mte-capstone-ecards/Ecardz-EE/Ecardz-Proto-Rev2/Ecardz-Proto.step

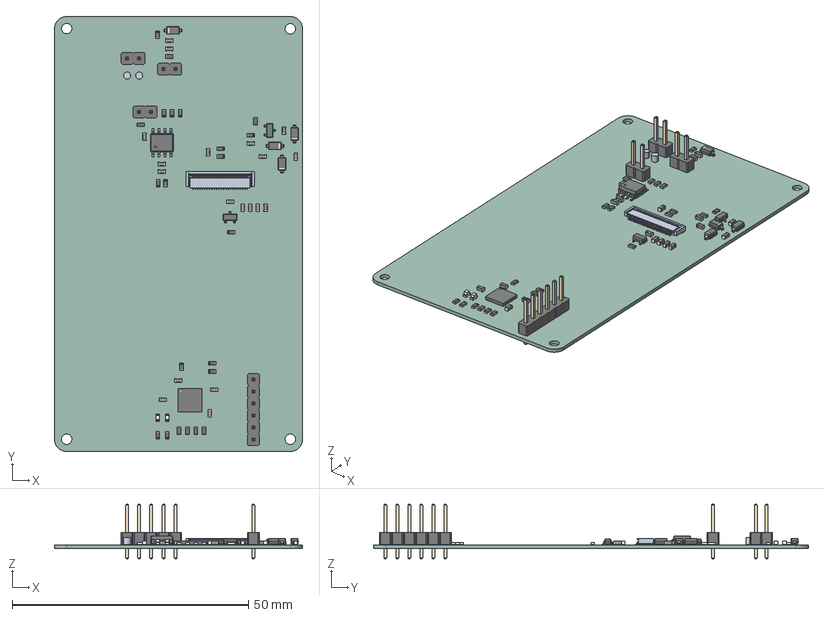
[picture p1: CAD file, 2025-03-11]
Ecardz-Proto-Rev2/Ecardz-Proto.step
52.5 x 92.0 x 11.5 mm
R_0603_1608Metric x 22
D_SOD_123 x 4
PinHeader_1x02_P254mm_Vertical x 3
C_0603_1608Metric x 19
SOT_23 x 2
LED_0603_1608Metric x 2
QFN-32-1EP_5x5mm_Pitch0.5mm
CQ assembly
Same_Sky_CPG-05-N-B x 2
PinHeader_1x06_P254mm_Vertical
P10051922_2410ELF
Ecardz-Proto_PCB
