mte-capstone-ecards/Ecardz-EE/highres_electronic_cards.dxf

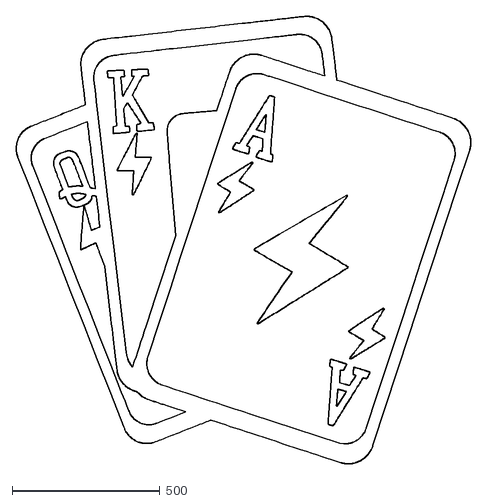
[picture p2: CAD file, 2025-02-24]
highres_electronic_cards.dxf
1536.4 x 1512.4
