mte-capstone-ecards/Ecardz-EE/Ecardz-Proto-Rev2/Same_Sky_CPG-05-N-B.step

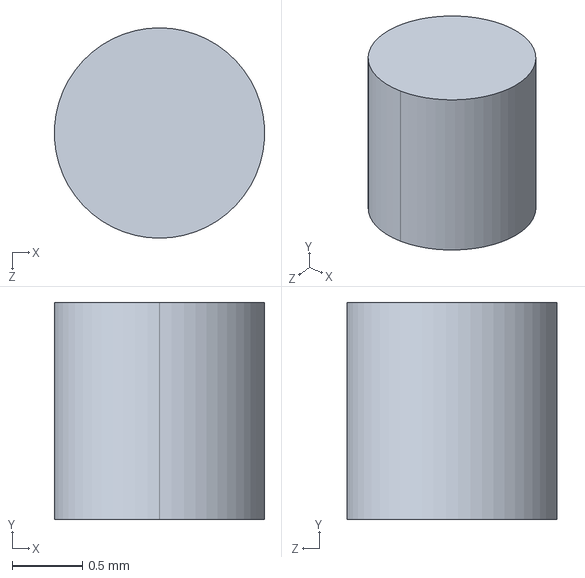
[picture p3: CAD file, 2025-02-23]
Ecardz-Proto-Rev2/Same_Sky_CPG-05-N-B.step
1.50 x 1.55 x 1.50 mm
