mte-capstone-ecards/Ecardz-EE/Ecardz-Proto-Rev2/s10051922_2410elf.stp

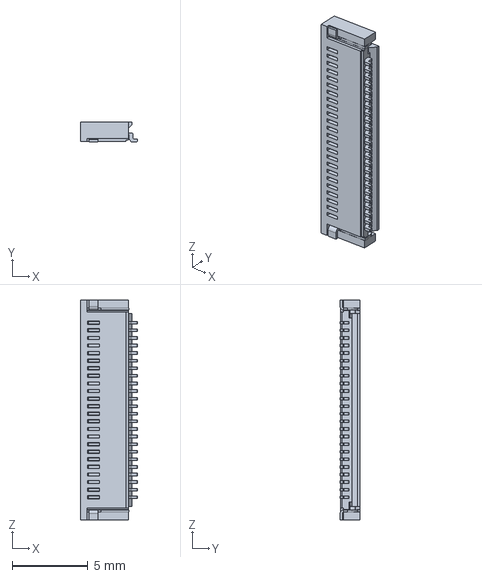
[picture p4: CAD file, 2025-02-23]
Ecardz-Proto-Rev2/s10051922_2410elf.stp
3.75 x 1.30 x 14.5 mm
