mte-capstone-ecards/Ecardz-EE/Ecardz-Proto-Rev2/Ecardz-Proto.kicad_pcb

## KiCad design Ecardz-Proto-Rev2/Ecardz-Proto.kicad_pcb (2025-03-11)

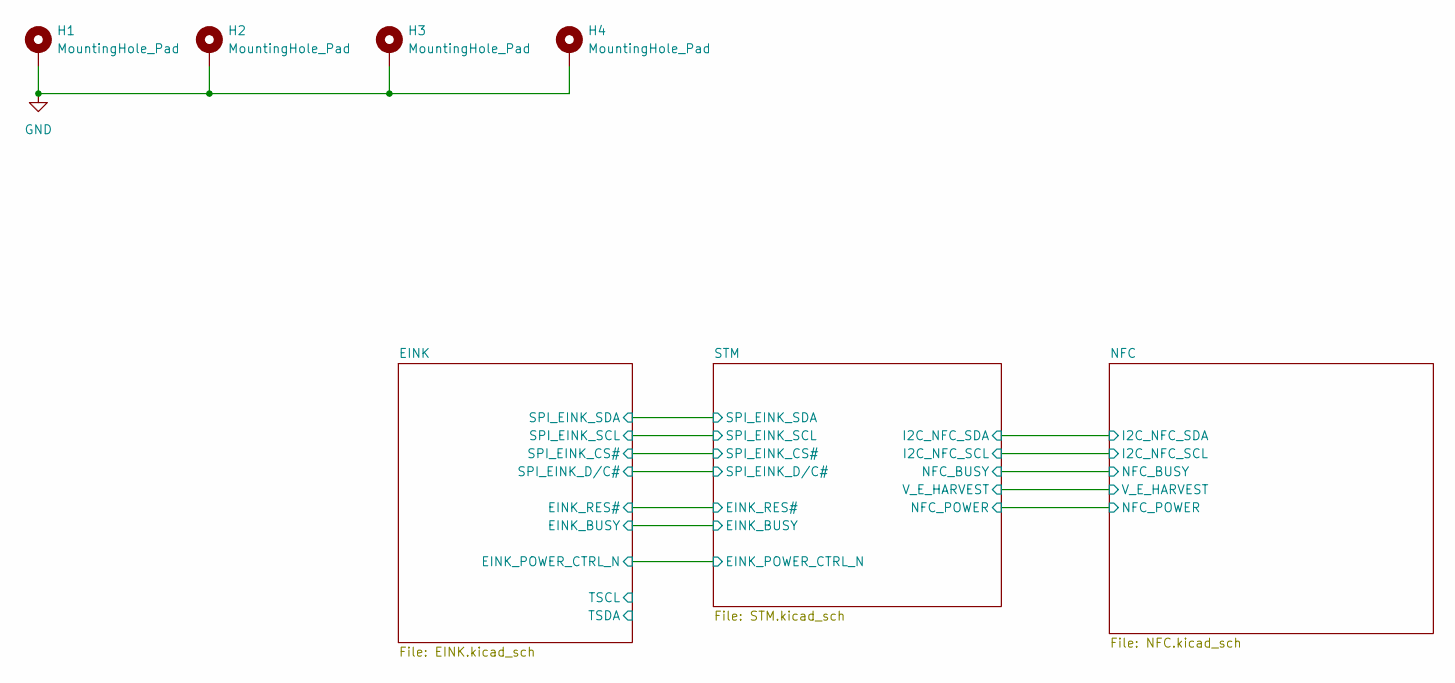
[picture p5: schematic Ecardz-Proto.kicad_sch]

Parts:
H1, H2, H3, H4: MountingHole_Pad; MountingHole_2.2mm_M2_DIN965

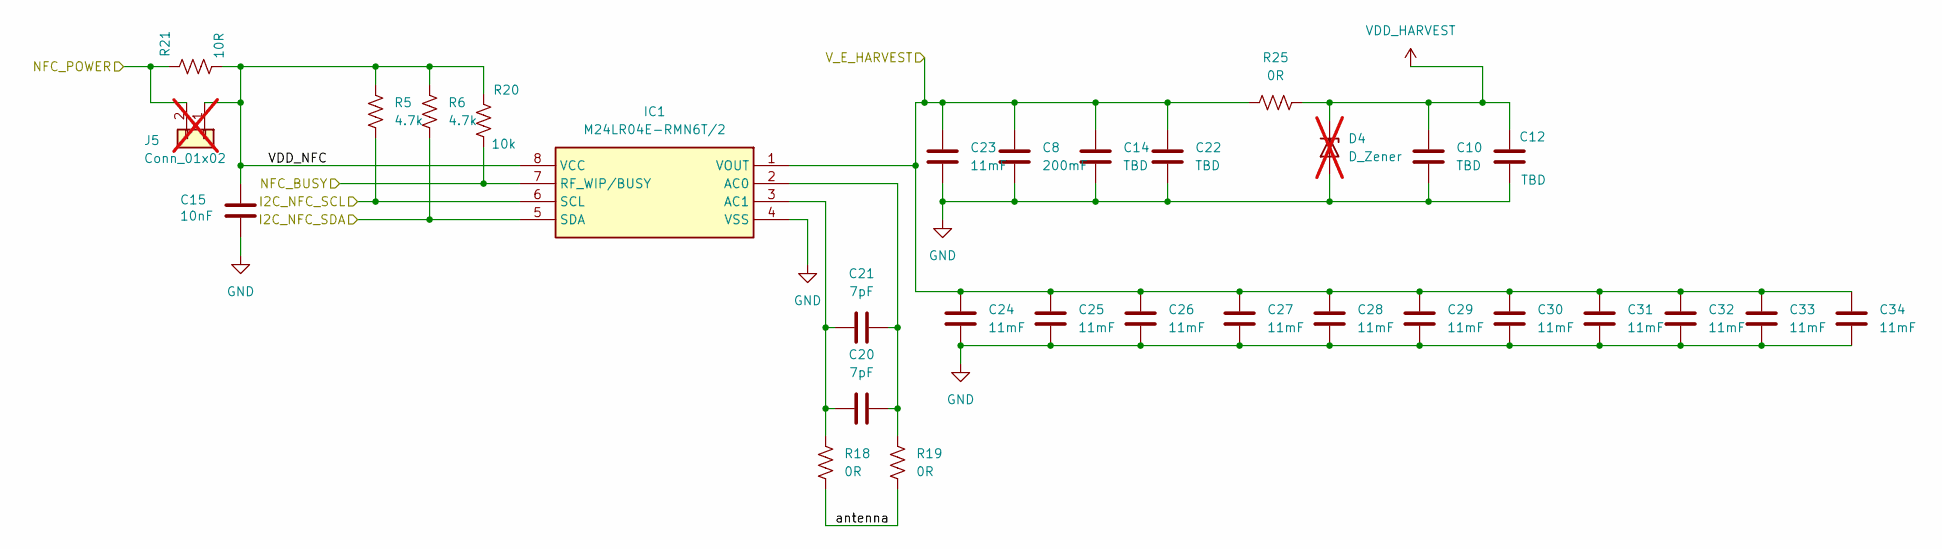
[picture p6: schematic NFC.kicad_sch]

Parts:
C8: 200mF; RSCSK2043R3D01004T; Digikey Part Number SCSK2043R3D01004T
C10, C12: TBD; C_0603_1608Metric_Pad1.08x0.95mm_HandSolder
C14, C22: TBD; C_2917
C15: 10nF; C_0603_1608Metric_Pad1.08x0.95mm_HandSolder; MANUFACTURER PART NUMBER C0603C102K5RACTU; Digikey Part Number 399-C0603C102K5RACTUTR-ND
C20, C21: 7pF; C_0603_1608Metric_Pad1.08x0.95mm_HandSolder; MANUFACTURER PART NUMBER GRM0335C1E7R0CA01D; Digikey Part Number 490-13324-2-ND
C23, C24, C25, C26, C27, C28, C29, C30, C31, C32, C33, C34: 11mF; CPH3225A; Digikey Part Number CPH3225A
D4: D_Zener; D_SOD-123; MANUFACTURER PART NUMBER MMSZ4684T1G; Digikey Part Number MMSZ4684T1GOSTR-ND; not fitted
IC1: M24LR04E-RMN6T/2; SO-8_3.9x4.9mm_P1.27mm; Mouser Part Number 511-M24LR04E-RDW6T/2
J5: Conn_01x02; PinHeader_1x02_P2.54mm_Vertical; not fitted
R5, R6: 4.7k; R_0603_1608Metric_Pad0.98x0.95mm_HandSolder; Part Number ERJ-3EKF4701V
R18, R19, R25: 0R; R_0603_1608Metric_Pad0.98x0.95mm_HandSolder; MANUFACTURER PART NUMBER CRCW0603590RFKEA; Digikey Part Number 541-590HTR-ND
R20: 10k; R_0603_1608Metric_Pad0.98x0.95mm_HandSolder; MANUFACTURER PART NUMBER RC0603FR-0710KL; Digikey Part Number 311-10.0KHRTR-ND
R21: 10R; R_0603_1608Metric_Pad0.98x0.95mm_HandSolder; MANUFACTURER PART NUMBER NRC06J100TRF

Connections:
/NFC/NFC_POWER: J5.2, R21.1; also elsewhere on the board
/NFC/VDD_NFC: C15.1, IC1.8 (VCC), J5.1, R5.1, R6.1, R20.1, R21.2
/NFC/V_E_HARVEST: C8.1, C14.1, C22.1, C23.1, C24.1, C25.1, C26.1, C27.1, C28.1, C29.1, C30.1, C31.1, C32.1, C33.1, C34.1, IC1.1 (VOUT), R25.1; also elsewhere on the board
/NFC/antenna: R18.1, R19.1
/STM/I2C_NFC_SCL: IC1.6 (SCL), R5.2; also elsewhere on the board
/STM/I2C_NFC_SDA: IC1.5 (SDA), R6.2; also elsewhere on the board
/STM/NFC_BUSY: IC1.7 (RF_WIP/BUSY), R20.2; also elsewhere on the board
GND: C8.2, C10.2, C12.2, C14.2, C15.2, C22.2, C23.2, C24.2, C25.2, C26.2, C27.2, C28.2, C29.2, C30.2, C31.2, C32.2, C33.2, C34.2, D4.2 (A), IC1.4 (VSS); also elsewhere on the board
unnamed: C20.2, C21.2, IC1.2 (AC0), R19.2
unnamed: C20.1, C21.1, IC1.3 (AC1), R18.2
VDD_HARVEST: C10.1, C12.1, D4.1 (K), R25.2; also elsewhere on the board

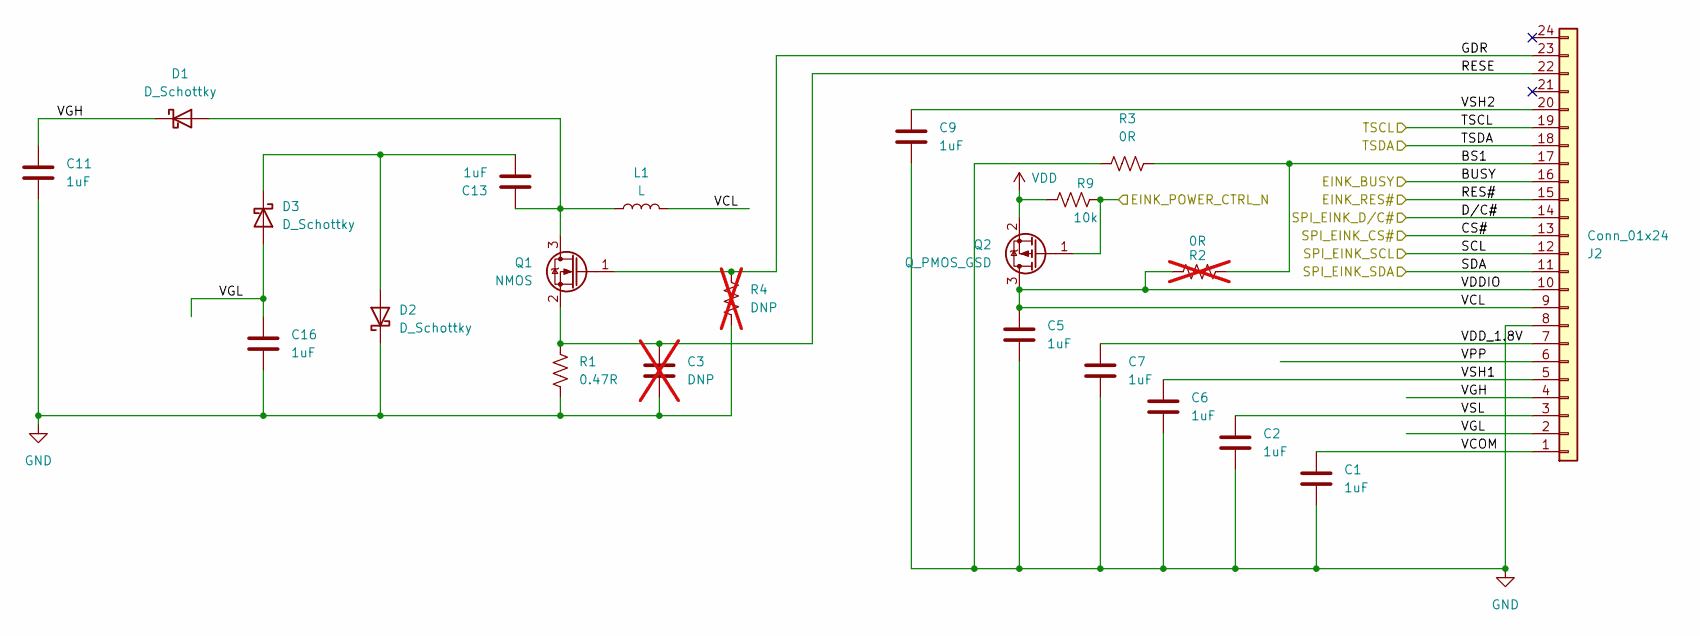
[picture p7: schematic EINK.kicad_sch]

Parts:
C1, C2, C5, C6, C7, C9, C11, C13, C16: 1uF; C_0603_1608Metric_Pad1.08x0.95mm_HandSolder; MANUFACTURER PART NUMBER CC0603KRX5R8BB105; Digikey Part Number 311-1445-2-ND
C3: DNP; C_0603_1608Metric_Pad1.08x0.95mm_HandSolder; MANUFACTURER PART NUMBER 100pF; not fitted
D1, D2, D3: D_Schottky; D_SOD-123; MANUFACTURER PART NUMBER MBR0530T1G; Digikey Part Number MBR0530T1GOSTR-ND
J2: Conn_01x24; TE_2-1734839-4_1x24-1MP_P0.5mm_Horizontal; MANUFACTURER PART NUMBER 4-1734839-5; Digikey Part Number A101358TR-ND
L1: L; CDRH5D18; MANUFACTURER PART NUMBER CDRH5D18NP-470NC; Digikey Part Number 308-2060-2-ND
Q1: NMOS; SOT-23; MANUFACTURER PART NUMBER IRLML2803TRPBF; Digikey Part Number IRLML2803PBFTR-ND
Q2: Q_PMOS_GSD; SOT-23; MANUFACTURER PART NUMBER BSS138NH6433XTMA1
R1: 0.47R; R_0603_1608Metric_Pad0.98x0.95mm_HandSolder; MANUFACTURER PART NUMBER ERJ-3RQJR47V; Digikey Part Number ERJ-3RQJR47V
R2: 0R; R_0603_1608Metric_Pad0.98x0.95mm_HandSolder; MANUFACTURER PART NUMBER RC0603JR-070RL; Digikey Part Number 311-0.0GRTR-ND; not fitted
R3: 0R; R_0603_1608Metric_Pad0.98x0.95mm_HandSolder; MANUFACTURER PART NUMBER RC0603JR-070RL; Digikey Part Number 311-0.0GRTR-ND
R4: DNP; R_0603_1608Metric_Pad0.98x0.95mm_HandSolder; MANUFACTURER PART NUMBER 100kR; not fitted
R9: 10k; R_0603_1608Metric_Pad0.98x0.95mm_HandSolder; MANUFACTURER PART NUMBER RC0603FR-0710KL; Digikey Part Number 311-10.0KHRTR-ND

Connections:
/EINK/BS1: J2.17, R2.2, R3.2
/EINK/BUSY: J2.16; also elsewhere on the board
/EINK/CS#: J2.13; also elsewhere on the board
/EINK/D/C#: J2.14; also elsewhere on the board
/EINK/EINK_POWER_CTRL_N: Q2.1 (G), R9.2; also elsewhere on the board
/EINK/GDR: J2.23, Q1.1 (G), R4.1
/EINK/RES#: J2.15; also elsewhere on the board
/EINK/RESE: C3.1, J2.22, Q1.2 (S), R1.1
/EINK/SCL: J2.12; also elsewhere on the board
/EINK/SDA: J2.11; also elsewhere on the board
/EINK/TSCL: J2.19
/EINK/TSDA: J2.18
/EINK/VCL: C5.1, J2.9, J2.10, L1.2, Q2.3 (D), R2.1
/EINK/VCOM: C1.1, J2.1
/EINK/VDD_1.8V: C7.1, J2.7
/EINK/VGH: C11.1, D1.1 (K), J2.4
/EINK/VGL: C16.1, D3.2 (A), J2.2
/EINK/VPP: J2.6
/EINK/VSH1: C6.1, J2.5
/EINK/VSH2: C9.1, J2.20
/EINK/VSL: C2.1, J2.3
GND: C1.2, C2.2, C3.2, C5.2, C6.2, C7.2, C9.2, C11.2, C16.2, D2.1 (K), J2.8, R1.2, R3.1, R4.2; also elsewhere on the board
unnamed: C13.1, D1.2 (A), L1.1, Q1.3 (D)
unnamed: C13.2, D2.2 (A), D3.1 (K)
VDD: Q2.2 (S), R9.1; also elsewhere on the board

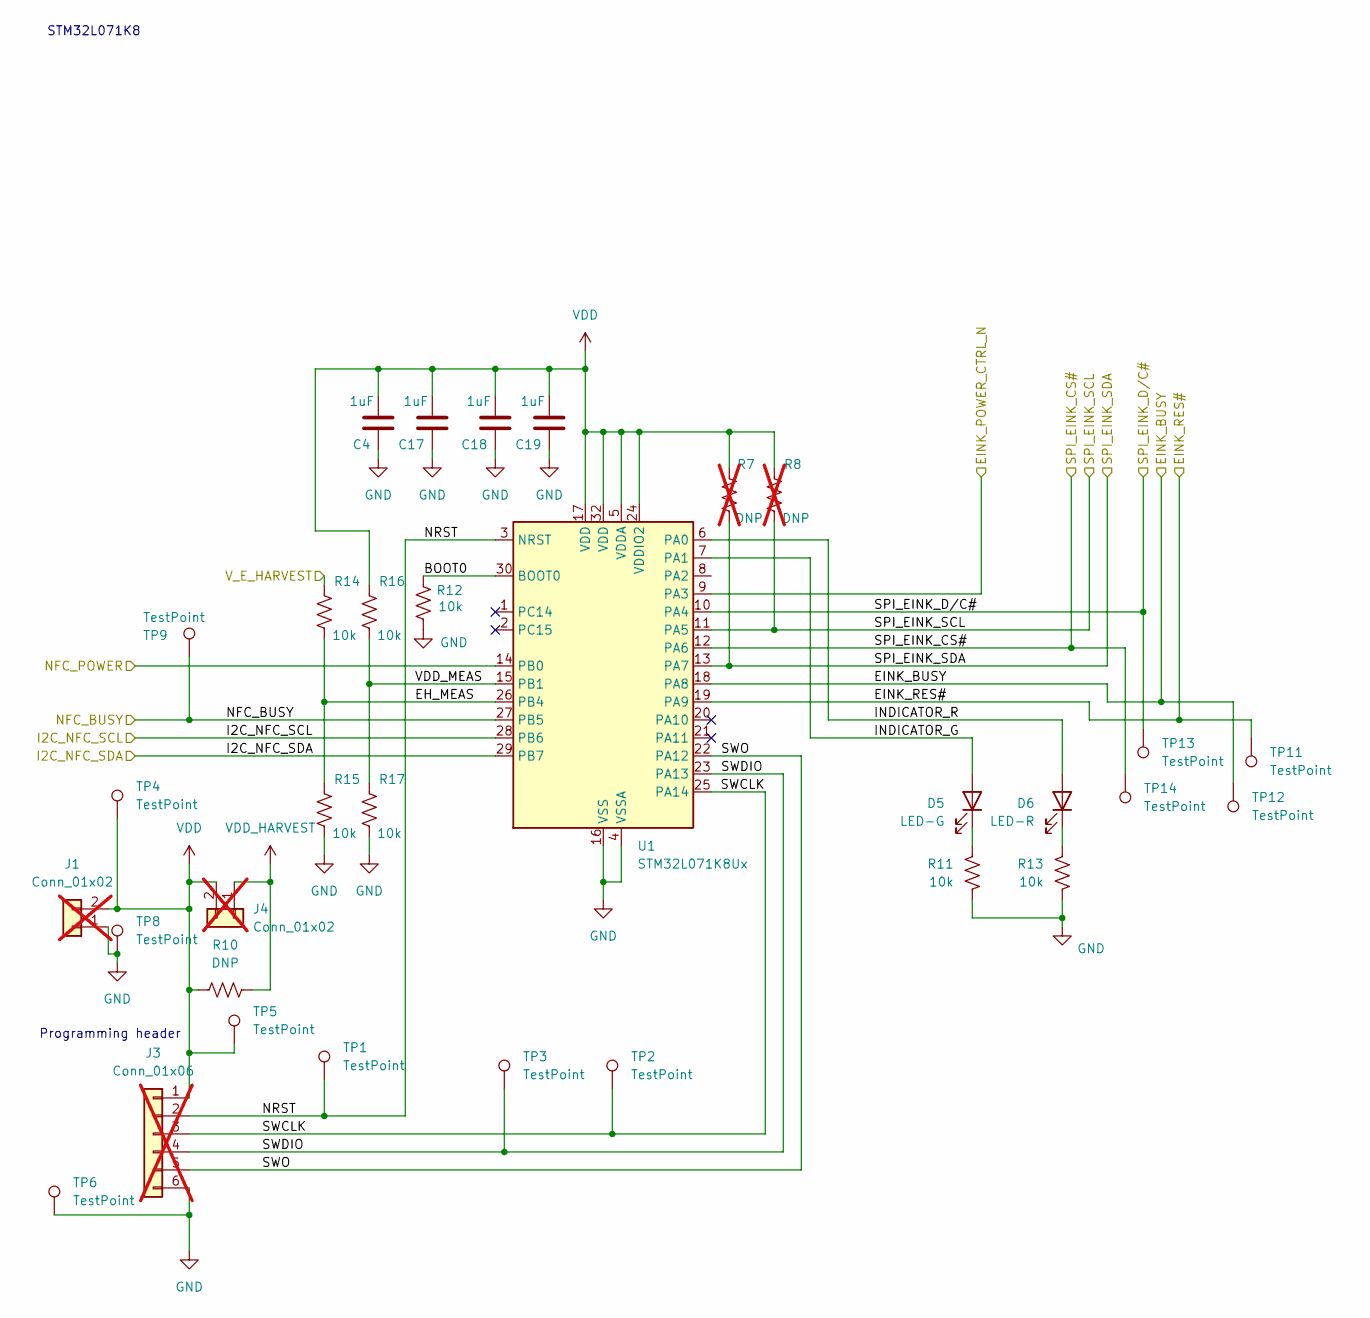
[picture p8: schematic STM.kicad_sch]

Parts:
C4, C17, C18, C19: 1uF; C_0603_1608Metric_Pad1.08x0.95mm_HandSolder; MANUFACTURER PART NUMBER CC0603KRX5R8BB105; Digikey Part Number 311-1445-2-ND
D5: LED-G; LED_0603_1608Metric_Pad1.05x0.95mm_HandSolder; MANUFACTURER PART NUMBER 150060GS75000
D6: LED-R; LED_0603_1608Metric_Pad1.05x0.95mm_HandSolder; MANUFACTURER PART NUMBER 150060RS75000
J1, J4: Conn_01x02; PinHeader_1x02_P2.54mm_Vertical; not fitted
J3: Conn_01x06; PinHeader_1x06_P2.54mm_Vertical; not fitted
R7, R8: DNP; R_0603_1608Metric_Pad0.98x0.95mm_HandSolder; MANUFACTURER PART NUMBER 100kR; not fitted
R10: DNP; R_0603_1608Metric_Pad0.98x0.95mm_HandSolder; MANUFACTURER PART NUMBER RC0603JR-070RL
R11, R13: 10k; R_0603_1608Metric_Pad0.98x0.95mm_HandSolder; Part Number RC0603FR-0710KL
R12, R14, R15, R16, R17: 10k; R_0603_1608Metric_Pad0.98x0.95mm_HandSolder; MANUFACTURER PART NUMBER RC0603FR-0710KL; Digikey Part Number 311-10.0KHRTR-ND
TP1, TP2, TP3, TP5, TP6, TP9, TP11, TP12, TP13, TP14: TestPoint; TestPoint_Pad_2.0x2.0mm
TP4, TP8: TestPoint; TestPoint_Pad_D1.5mm
U1: STM32L071K8Ux; QFN-32-1EP_5x5mm_P0.5mm_EP3.45x3.45mm; MANUFACTURER PART NUMBER STM32L071K8U6; Digikey Part Number 497-18576-ND

Connections:
/EINK/BUSY: TP12.1, U1.18 (PA8); also elsewhere on the board
/EINK/CS#: TP14.1, U1.12 (PA6); also elsewhere on the board
/EINK/D/C#: TP13.1, U1.10 (PA4); also elsewhere on the board
/EINK/EINK_POWER_CTRL_N: U1.9 (PA3); also elsewhere on the board
/EINK/RES#: TP11.1, U1.19 (PA9); also elsewhere on the board
/EINK/SCL: R8.2, U1.11 (PA5); also elsewhere on the board
/EINK/SDA: R7.2, U1.13 (PA7); also elsewhere on the board
/NFC/NFC_POWER: U1.14 (PB0); also elsewhere on the board
/NFC/V_E_HARVEST: R14.1; also elsewhere on the board
/STM/BOOT0: R12.1, U1.30 (BOOT0)
/STM/EH_MEAS: R14.2, R15.1, U1.26 (PB4)
/STM/I2C_NFC_SCL: U1.28 (PB6); also elsewhere on the board
/STM/I2C_NFC_SDA: U1.29 (PB7); also elsewhere on the board
/STM/INDICATOR_G: D5.2 (A), U1.7 (PA1)
/STM/INDICATOR_R: D6.2 (A), U1.6 (PA0)
/STM/NFC_BUSY: TP9.1, U1.27 (PB5); also elsewhere on the board
/STM/NRST: J3.2, TP1.1, U1.3 (NRST)
/STM/SWCLK: J3.3, TP2.1, U1.25 (PA14)
/STM/SWDIO: J3.4, TP3.1, U1.23 (PA13)
/STM/SWO: J3.5, U1.22 (PA12)
/STM/VDD_MEAS: R16.2, R17.1, U1.15 (PB1)
GND: C4.1, C17.1, C18.1, C19.1, J1.1, J3.6, R11.2, R12.2, R13.2, R15.2, R17.2, TP6.1, TP8.1, U1.4 (VSSA), U1.16 (VSS), U1.31 (VSS), U1.33 (VSS); also elsewhere on the board
unnamed: D5.1 (K), R11.1
unnamed: D6.1 (K), R13.1
VDD: C4.2, C17.2, C18.2, C19.2, J1.2, J3.1, J4.2, R7.1, R8.1, R10.1, R16.1, TP4.1, TP5.1, U1.5 (VDDA), U1.17 (VDD), U1.24 (VDDIO2), U1.32 (VDD); also elsewhere on the board
VDD_HARVEST: J4.1, R10.2; also elsewhere on the board

Notes on the sheet:
STM32L071K8
Programming header

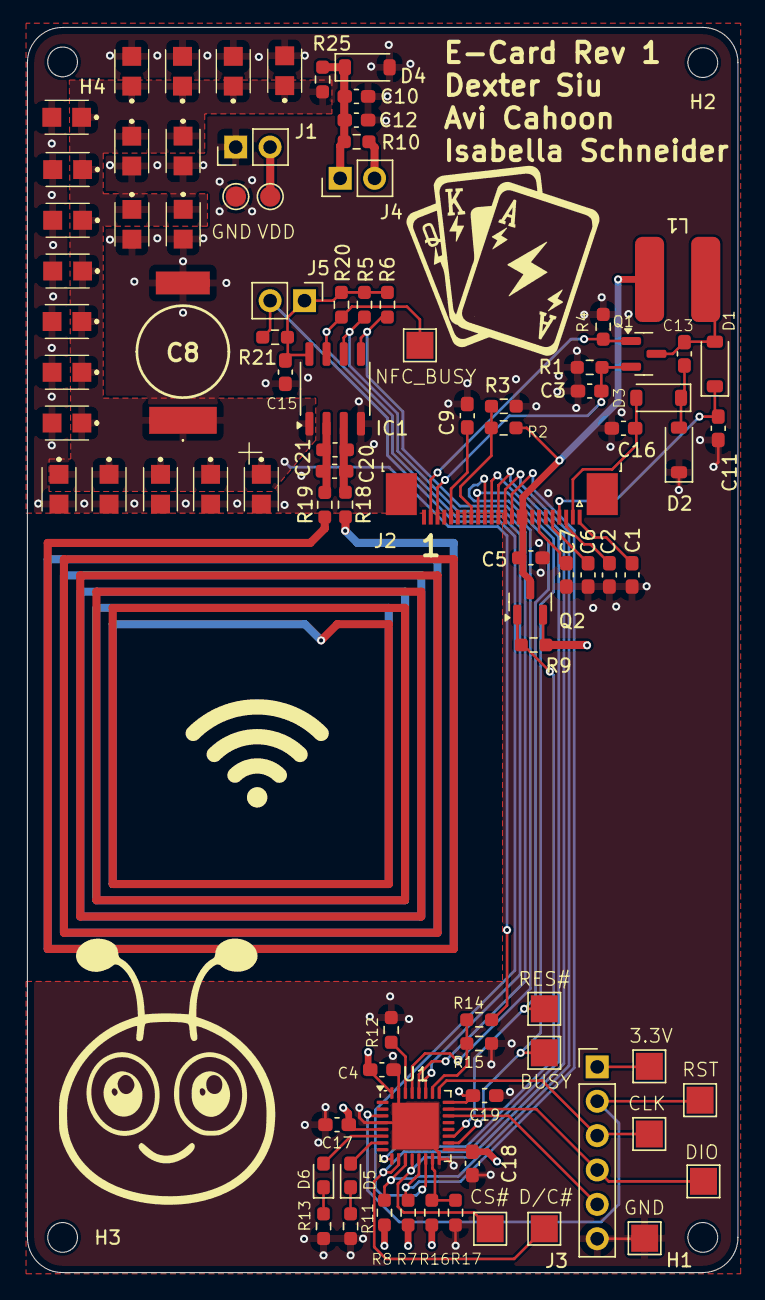
[picture p9: board Ecardz-Proto-Rev2/Ecardz-Proto.kicad_pcb from above]

Board: 4 copper layers, 52.5 x 92.0 mm, 94 parts (0 on the bottom side), 43 nets.

Other parts of the board:
C23#2, C23#3, C26#2, C26#3, C26#4, C30#2, C30#3, C30#4: 11mF; CPH3225A

Their connections:
/NFC/V_E_HARVEST: C23#2.1, C23#3.1, C26#2.1, C26#3.1, C26#4.1, C30#2.1, C30#3.1, C30#4.1; also elsewhere on the board
GND: C23#2.2, C23#3.2, C26#2.2, C26#3.2, C26#4.2, C30#2.2, C30#3.2, C30#4.2; also elsewhere on the board
