mte-capstone-ecards/Ecardz-EE/Ecardz-Controller/Ecardz-Controller.kicad_pcb

## KiCad design Ecardz-Controller/Ecardz-Controller.kicad_pcb (2025-01-20)

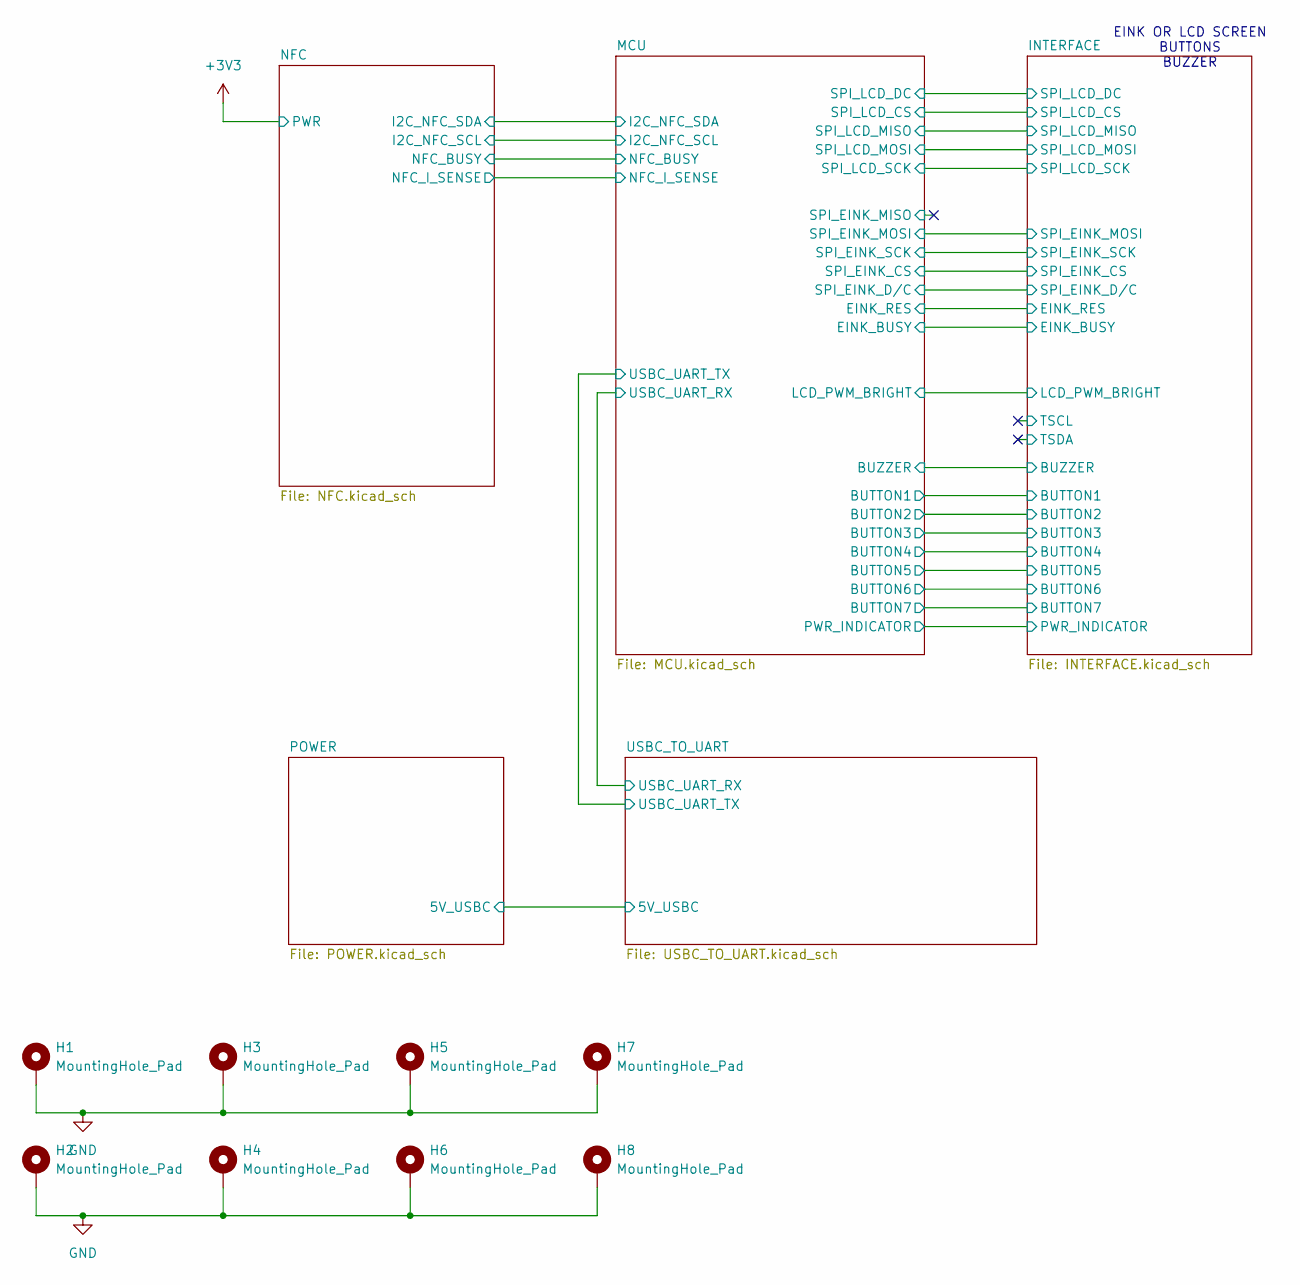
[picture p10: schematic Ecardz-Controller.kicad_sch]

Parts:
H1, H2, H3, H4, H5, H6, H7, H8: MountingHole_Pad; MountingHole_2.7mm_M2.5_Pad_TopBottom

Connections:
GND: H1.1, H2.1, H3.1, H4.1, H5.1, H6.1, H7.1, H8.1; also elsewhere on the board

Notes on the sheet:
EINK OR LCD SCREEN BUTTONS BUZZER

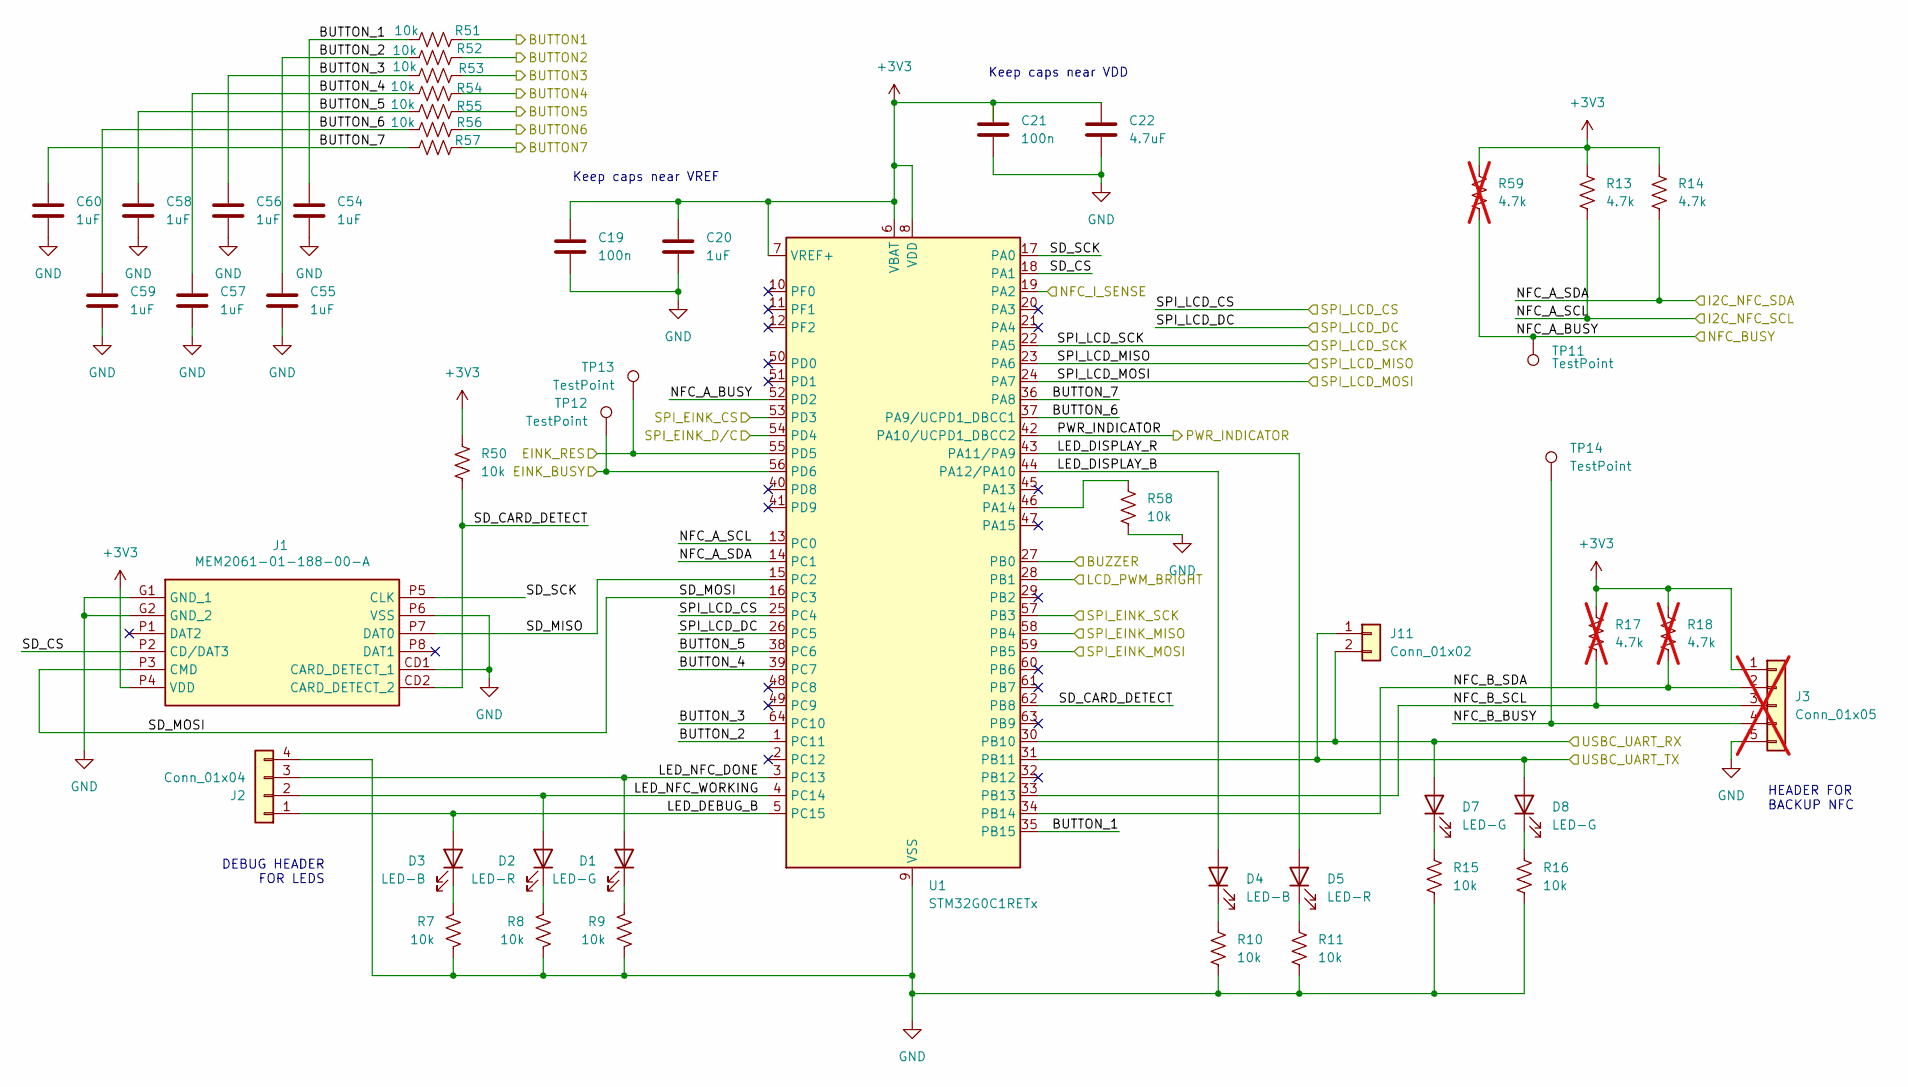
[picture p11: schematic MCU.kicad_sch]

Parts:
C19, C21: 100n; C_0603_1608Metric_Pad1.08x0.95mm_HandSolder; Part Number CC0603KRX7R7BB104
C20, C54, C55, C56, C57, C58, C59, C60: 1uF; C_0603_1608Metric_Pad1.08x0.95mm_HandSolder; Part Number CC0603KRX5R8BB105
C22: 4.7uF; C_0603_1608Metric_Pad1.08x0.95mm_HandSolder; Part Number CL10A475KP8NNNC
D1, D7, D8: LED-G; LED_0603_1608Metric_Pad1.05x0.95mm_HandSolder; Part Number 150060GS75000
D2, D5: LED-R; LED_0603_1608Metric_Pad1.05x0.95mm_HandSolder; Part Number 150060RS75000
D3, D4: LED-B; LED_0603_1608Metric_Pad1.05x0.95mm_HandSolder; Part Number 150060BS75000
J1: MEM2061-01-188-00-A; MEM20610118800A; Mouser Part Number 640-MEM20610118800A
J2: Conn_01x04; PinHeader_1x04_P2.54mm_Horizontal; Part Number 61300411121
J3: Conn_01x05; PinHeader_1x05_P2.54mm_Horizontal; Part Number 61300511121; not fitted
J11: Conn_01x02; PinHeader_1x02_P2.54mm_Horizontal
R7, R8, R9, R10, R11, R15, R16, R50, R51, R52, R53, R54, R55, R56, R57, R58: 10k; R_0603_1608Metric_Pad0.98x0.95mm_HandSolder; Part Number RC0603FR-0710KL
R13, R14: 4.7k; R_0603_1608Metric_Pad0.98x0.95mm_HandSolder; Part Number ERJ-3EKF4701V
R17, R18, R59: 4.7k; R_0603_1608Metric_Pad0.98x0.95mm_HandSolder; Part Number ERJ-3EKF4701V; not fitted
TP11, TP12, TP13, TP14: TestPoint; TestPoint_Pad_D3.0mm
U1: STM32G0C1RETx; LQFP-64_10x10mm_P0.5mm; Part Number STM32G0C1RETx

Connections:
+3V3: C19.1, C20.1, C21.1, C22.1, J1.P4 (VDD), J3.1, R13.1, R14.1, R17.1, R18.1, R50.1, R59.1, U1.6 (VBAT), U1.7 (VREF+), U1.8 (VDD); also elsewhere on the board
/INTERFACE/BUSY: TP12.1, U1.56 (PD6); also elsewhere on the board
/INTERFACE/BUTTON1: R51.2; also elsewhere on the board
/INTERFACE/BUTTON2: R52.2; also elsewhere on the board
/INTERFACE/BUTTON3: R53.2; also elsewhere on the board
/INTERFACE/BUTTON4: R54.2; also elsewhere on the board
/INTERFACE/BUTTON5: R55.2; also elsewhere on the board
/INTERFACE/BUTTON6: R56.2; also elsewhere on the board
/INTERFACE/BUTTON7: R57.2; also elsewhere on the board
/INTERFACE/BUZZER: U1.27 (PB0); also elsewhere on the board
/INTERFACE/CS#: U1.53 (PD3); also elsewhere on the board
/INTERFACE/D/C#: U1.54 (PD4); also elsewhere on the board
/INTERFACE/LCD_PWM_BRIGHT: U1.28 (PB1); also elsewhere on the board
/INTERFACE/RES#: TP13.1, U1.55 (PD5); also elsewhere on the board
/INTERFACE/SCL: U1.57 (PB3); also elsewhere on the board
/INTERFACE/SDA: U1.59 (PB5); also elsewhere on the board
/MCU/BUTTON_1: C54.1, R51.1, U1.35 (PB15)
/MCU/BUTTON_2: C55.1, R52.1, U1.1 (PC11)
/MCU/BUTTON_3: C56.1, R53.1, U1.64 (PC10)
/MCU/BUTTON_4: C57.1, R54.1, U1.39 (PC7)
/MCU/BUTTON_5: C58.1, R55.1, U1.38 (PC6)
/MCU/BUTTON_6: C59.1, R56.1, U1.37 (PA9/UCPD1_DBCC1)
/MCU/BUTTON_7: C60.1, R57.1, U1.36 (PA8)
/MCU/LED_DEBUG_B: D3.2 (A), J2.1, U1.5 (PC15)
/MCU/LED_DISPLAY_B: D4.2 (A), U1.44 (PA12/PA10)
/MCU/LED_DISPLAY_R: D5.2 (A), U1.43 (PA11/PA9)
/MCU/LED_NFC_DONE: D1.2 (A), J2.3, U1.3 (PC13)
/MCU/LED_NFC_WORKING: D2.2 (A), J2.2, U1.4 (PC14)
/MCU/NFC_A_BUSY: R59.2, TP11.1, U1.52 (PD2); also elsewhere on the board
/MCU/NFC_A_SCL: R13.2, U1.13 (PC0); also elsewhere on the board
/MCU/NFC_A_SDA: R14.2, U1.14 (PC1); also elsewhere on the board
/MCU/NFC_B_BUSY: J3.4, TP14.1
/MCU/NFC_B_SCL: J3.3, R17.2, U1.33 (PB13)
/MCU/NFC_B_SDA: J3.2, R18.2, U1.34 (PB14)
/MCU/NFC_I_SENSE: U1.19 (PA2); also elsewhere on the board
/MCU/PWR_INDICATOR: U1.42 (PA10/UCPD1_DBCC2); also elsewhere on the board
/MCU/SD_CARD_DETECT: J1.CD2 (CARD_DETECT_2), R50.2, U1.62 (PB8)
/MCU/SD_CS: J1.P2 (CD/DAT3), U1.18 (PA1)
/MCU/SD_MISO: J1.P7 (DAT0), U1.15 (PC2)
/MCU/SD_MOSI: J1.P3 (CMD), U1.16 (PC3)
/MCU/SD_SCK: J1.P5 (CLK), U1.17 (PA0)
/MCU/SPI_EINK_MISO: U1.58 (PB4)
/MCU/SPI_LCD_CS: U1.25 (PC4); also elsewhere on the board
/MCU/SPI_LCD_DC: U1.26 (PC5); also elsewhere on the board
/MCU/SPI_LCD_MISO: U1.23 (PA6); also elsewhere on the board
/MCU/SPI_LCD_MOSI: U1.24 (PA7); also elsewhere on the board
/MCU/SPI_LCD_SCK: U1.22 (PA5); also elsewhere on the board
/MCU/USBC_UART_RX: D7.2 (A), J11.2, U1.30 (PB10); also elsewhere on the board
/MCU/USBC_UART_TX: D8.2 (A), J11.1, U1.31 (PB11); also elsewhere on the board
GND: C19.2, C20.2, C21.2, C22.2, C54.2, C55.2, C56.2, C57.2, C58.2, C59.2, C60.2, J1.CD1 (CARD_DETECT_1), J1.G1 (GND_1), J1.G2 (GND_2), J1.P6 (VSS), J2.4, J3.5, R7.2, R8.2, R9.2, R10.2, R11.2, R15.2, R16.2, R58.2, U1.9 (VSS); also elsewhere on the board
unnamed: D1.1 (K), R9.1
unnamed: D2.1 (K), R8.1
unnamed: D3.1 (K), R7.1
unnamed: D4.1 (K), R10.1
unnamed: D5.1 (K), R11.1
unnamed: D7.1 (K), R15.1
unnamed: D8.1 (K), R16.1
unnamed: R58.1, U1.46 (PA14)

Notes on the sheet:
HEADER FOR BACKUP NFC
DEBUG HEADER FOR LEDS
Keep caps near VDD
Keep caps near VREF

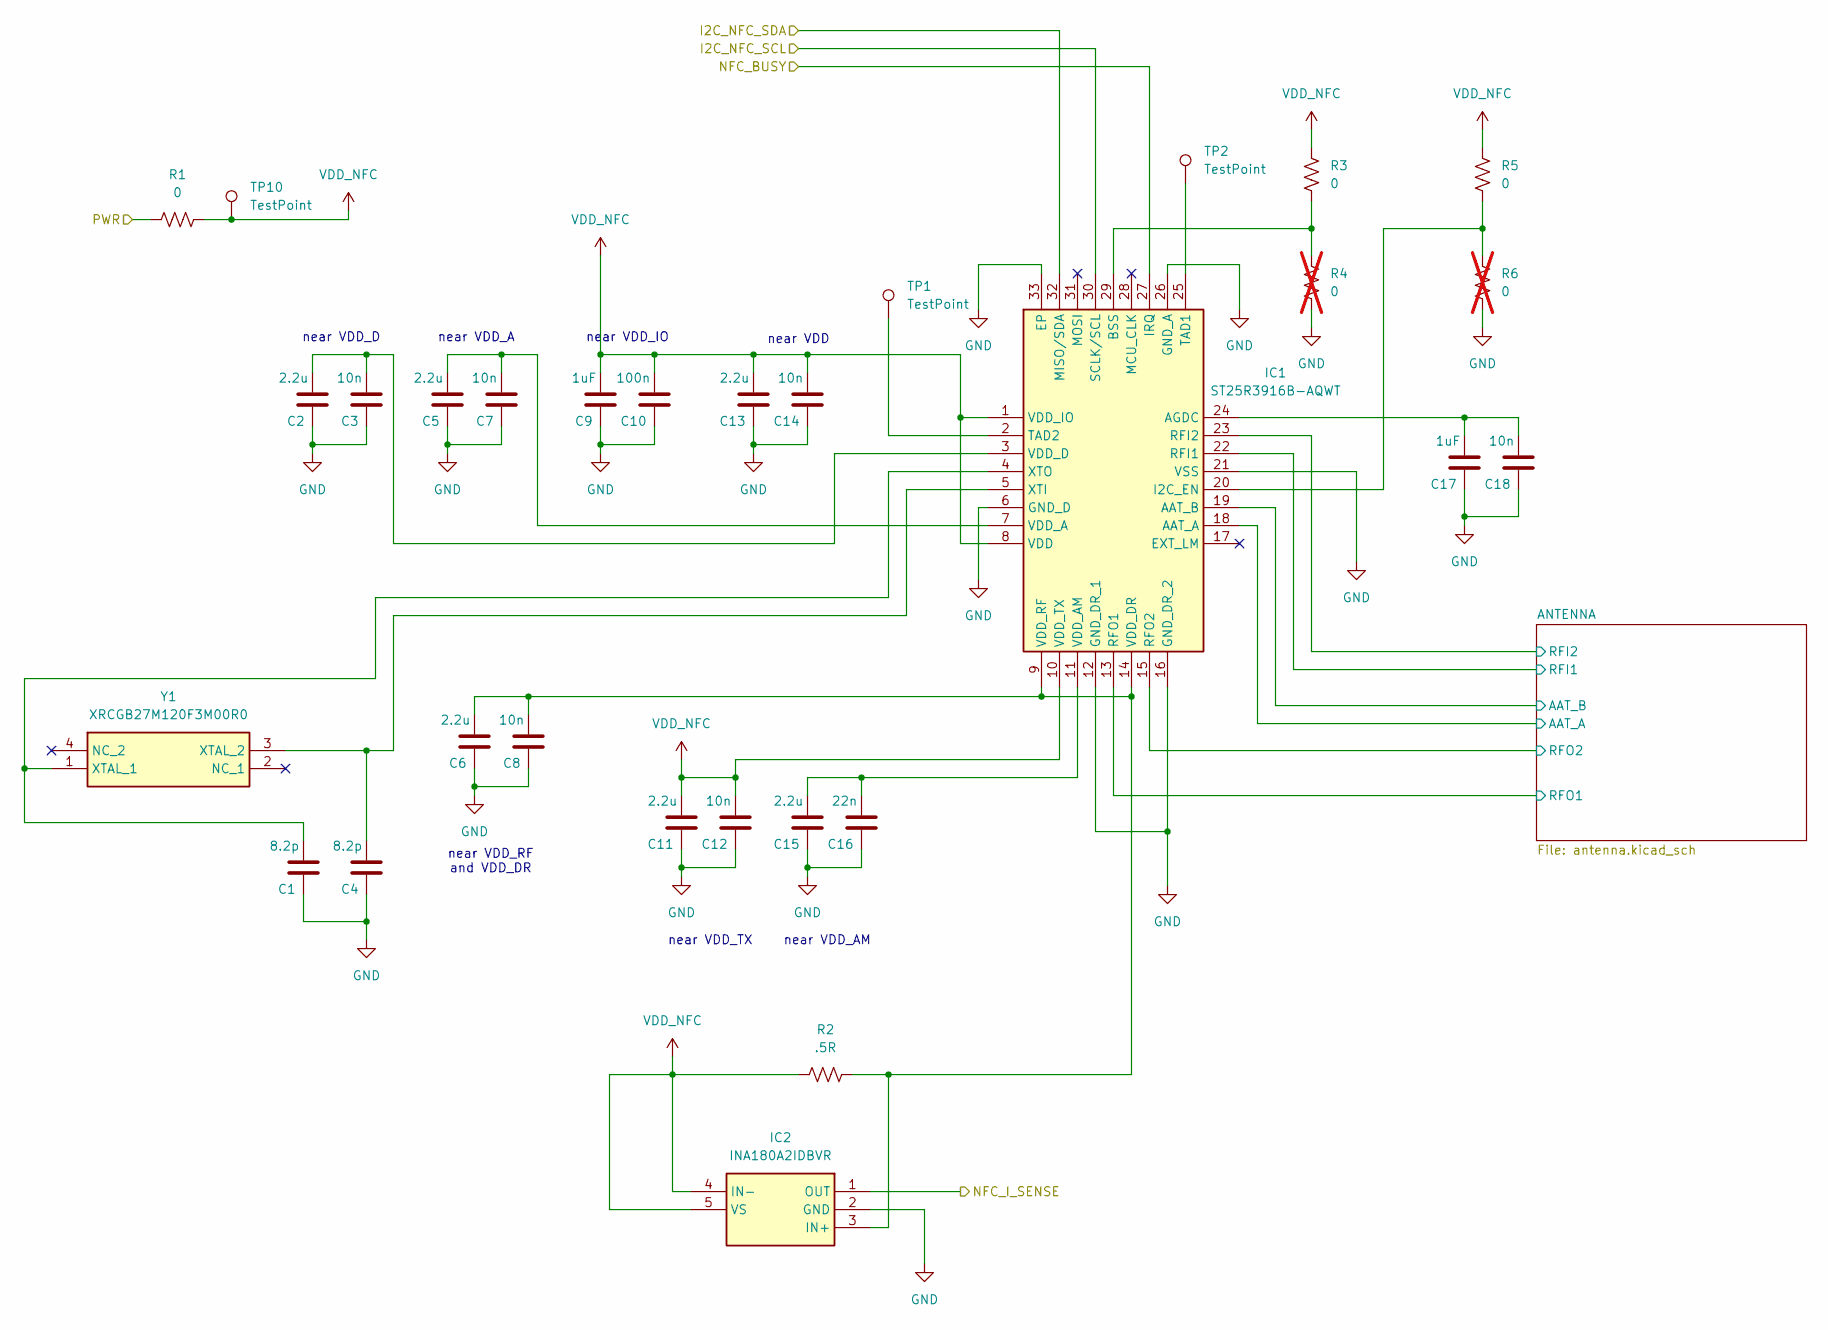
[picture p12: schematic NFC.kicad_sch]

Parts:
C1, C4: 8.2p; C_0603_1608Metric_Pad1.08x0.95mm_HandSolder; MANUFACTURER PART NUMBER CC0603KRX5R8BB105; Digikey Part Number 311-1445-2-ND
C2, C5, C6, C11, C13, C15: 2.2u; C_0603_1608Metric_Pad1.08x0.95mm_HandSolder; MANUFACTURER PART NUMBER CC0603KRX5R8BB105; Digikey Part Number 311-1445-2-ND
C3, C7, C8, C12, C14, C18: 10n; C_0603_1608Metric_Pad1.08x0.95mm_HandSolder; MANUFACTURER PART NUMBER CC0603KRX5R8BB105; Digikey Part Number 311-1445-2-ND
C9, C17: 1uF; C_0603_1608Metric_Pad1.08x0.95mm_HandSolder; MANUFACTURER PART NUMBER CC0603KRX5R8BB105; Digikey Part Number 311-1445-2-ND
C10: 100n; C_0603_1608Metric_Pad1.08x0.95mm_HandSolder; MANUFACTURER PART NUMBER CC0603KRX5R8BB105; Digikey Part Number 311-1445-2-ND
C16: 22n; C_0603_1608Metric_Pad1.08x0.95mm_HandSolder; MANUFACTURER PART NUMBER CC0603KRX5R8BB105; Digikey Part Number 311-1445-2-ND
IC1: ST25R3916B-AQWT; QFN50P500X500X100-33N-D; Mouser Part Number 511-ST25R3916B-AQWT
IC2: INA180A2IDBVR; SOT95P280X145-5N; Mouser Part Number 595-INA180A2IDBVR
R1, R3, R5: 0; R_0603_1608Metric_Pad0.98x0.95mm_HandSolder; MANUFACTURER PART NUMBER CRCW0603590RFKEA; Digikey Part Number 541-590HTR-ND
R2: .5R; R_0603_1608Metric_Pad0.98x0.95mm_HandSolder; MANUFACTURER PART NUMBER CRCW0603590RFKEA; Digikey Part Number 541-590HTR-ND
R4, R6: 0; R_0603_1608Metric_Pad0.98x0.95mm_HandSolder; MANUFACTURER PART NUMBER CRCW0603590RFKEA; Digikey Part Number 541-590HTR-ND; not fitted
TP1, TP2, TP10: TestPoint; TestPoint_Pad_D3.0mm
Y1: XRCGB27M120F3M00R0; XRCGB; Mouser Part Number 81-XRCGB27M120F3M0R0

Connections:
+3V3: R1.2; also elsewhere on the board
/MCU/NFC_A_BUSY: IC1.27 (IRQ); also elsewhere on the board
/MCU/NFC_A_SCL: IC1.30 (SCLK/SCL); also elsewhere on the board
/MCU/NFC_A_SDA: IC1.32 (MISO/SDA); also elsewhere on the board
/MCU/NFC_I_SENSE: IC2.1 (OUT); also elsewhere on the board
/NFC/ANTENNA/AAT_A: IC1.18 (AAT_A); also elsewhere on the board
/NFC/ANTENNA/AAT_B: IC1.19 (AAT_B); also elsewhere on the board
/NFC/ANTENNA/RFI1: IC1.22 (RFI1); also elsewhere on the board
/NFC/ANTENNA/RFI2: IC1.23 (RFI2); also elsewhere on the board
/NFC/ANTENNA/RFO1: IC1.13 (RFO1); also elsewhere on the board
/NFC/ANTENNA/RFO2: IC1.15 (RFO2); also elsewhere on the board
GND: C1.1, C2.1, C3.1, C4.1, C5.1, C6.1, C7.1, C8.1, C9.1, C10.1, C11.1, C12.1, C13.1, C14.1, C15.1, C16.1, C17.1, C18.1, IC1.6 (GND_D), IC1.12 (GND_DR_1), IC1.16 (GND_DR_2), IC1.21 (VSS), IC1.26 (GND_A), IC1.33 (EP), IC2.2 (GND), R4.1, R6.1; also elsewhere on the board
unnamed: C17.2, C18.2, IC1.24 (AGDC)
unnamed: IC1.29 (BSS), R3.1, R4.2
unnamed: IC1.20 (I2C_EN), R5.1, R6.2
unnamed: IC1.25 (TAD1), TP2.1
unnamed: IC1.2 (TAD2), TP1.1
unnamed: C5.2, C7.2, IC1.7 (VDD_A)
unnamed: C15.2, C16.2, IC1.11 (VDD_AM)
unnamed: C2.2, C3.2, IC1.3 (VDD_D)
unnamed: C6.2, C8.2, IC1.9 (VDD_RF), IC1.14 (VDD_DR), IC2.3 (IN+), R2.2
unnamed: C4.2, IC1.5 (XTI), Y1.3 (XTAL_2)
unnamed: C1.2, IC1.4 (XTO), Y1.1 (XTAL_1)
VDD_NFC: C9.2, C10.2, C11.2, C12.2, C13.2, C14.2, IC1.1 (VDD_IO), IC1.8 (VDD), IC1.10 (VDD_TX), IC2.4 (IN-), IC2.5 (VS), R1.1, R2.1, R3.2, R5.2, TP10.1

Notes on the sheet:
near VDD_RF and VDD_DR
near VDD_AM
near VDD
near VDD_IO
near VDD_A
near VDD_D
near VDD_TX
