mte-capstone-ecards/Ecardz-EE/Ecardz-Controller/Ecardz-Controller.kicad_pcb

## KiCad design Ecardz-Controller/Ecardz-Controller.kicad_pcb (continued)

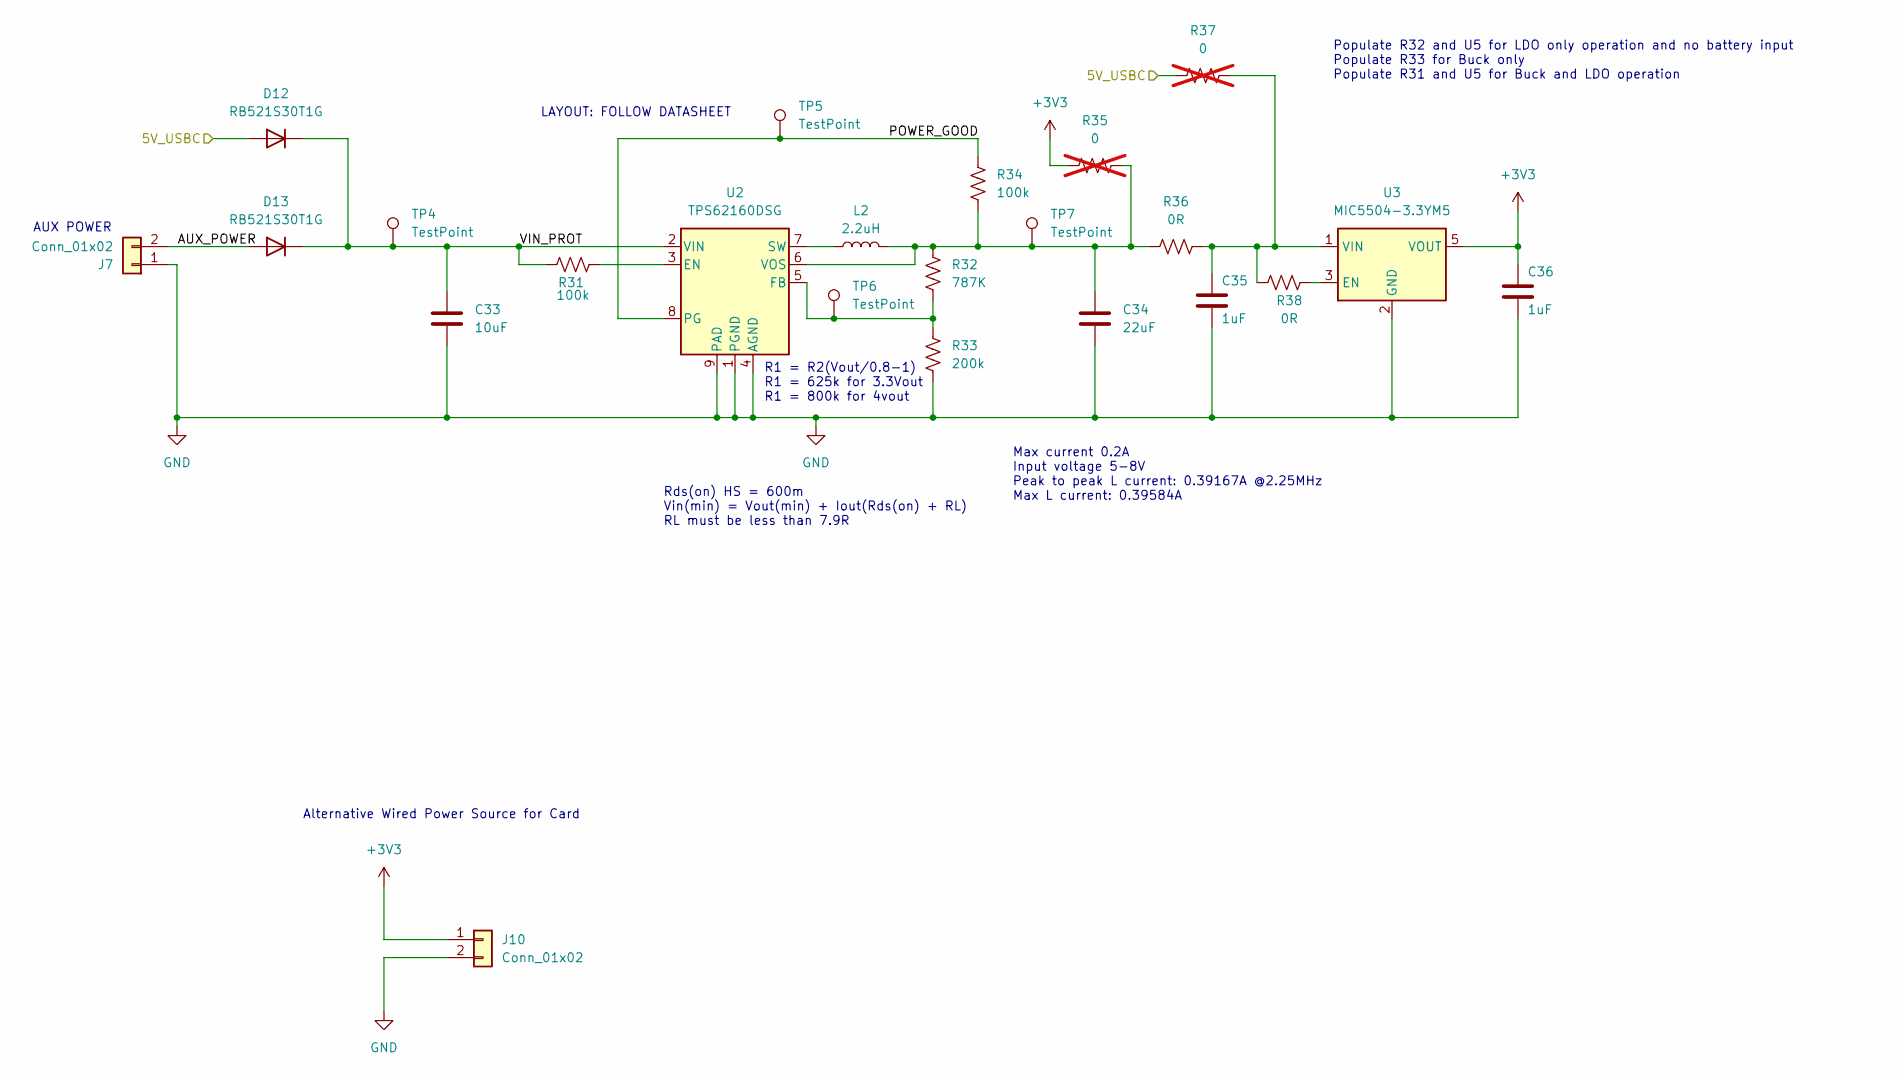
[picture p13: schematic POWER.kicad_sch]

Parts:
C33: 10uF; C_0805_2012Metric_Pad1.18x1.45mm_HandSolder; Part Number GRM21BR61C106KE15K
C34: 22uF; C_0805_2012Metric_Pad1.18x1.45mm_HandSolder; Part Number GRM21BR61A226ME51K
C35, C36: 1uF; C_0603_1608Metric_Pad1.08x0.95mm_HandSolder; Part Number CC0603KRX5R8BB105
D12, D13: RB521S30T1G; D_SOD-523; Part Number RB521S30T1G
J7, J10: Conn_01x02; PinHeader_1x02_P2.54mm_Horizontal; Part Number 61300211121
L2: 2.2uH; VLS2016; Part Number VLS201610CX-2R2M-1
R31, R34: 100k; R_0603_1608Metric_Pad0.98x0.95mm_HandSolder; Part Number RC0603FR-07100KL
R32: 787K; R_0603_1608Metric_Pad0.98x0.95mm_HandSolder; Part Number ERJ-3EKF7873V
R33: 200k; R_0603_1608Metric_Pad0.98x0.95mm_HandSolder; Part Number RC0603JR-07200KL
R35, R37: 0; R_0603_1608Metric_Pad0.98x0.95mm_HandSolder; MANUFACTURER PART NUMBER RC0603JR-070RL; Digikey Part Number 311-0.0GRTR-ND; not fitted
R36, R38: 0R; R_0603_1608Metric_Pad0.98x0.95mm_HandSolder; MANUFACTURER PART NUMBER RC0603JR-070RL; Digikey Part Number 311-0.0GRTR-ND
TP4, TP5, TP6, TP7: TestPoint; TestPoint_Pad_D3.0mm
U2: TPS62160DSG; WSON-8-1EP_2x2mm_P0.5mm_EP0.9x1.6mm_ThermalVias; Part Number TPS62160DSG
U3: MIC5504-3.3YM5; SOT-23-5; Part Number MIC5504-3.3YM5-TR

Connections:
+3V3: C36.1, J10.1, R35.1, U3.5 (VOUT); also elsewhere on the board
/POWER/5V_USBC: D12.2 (A), R37.1; also elsewhere on the board
/POWER/AUX_POWER: D13.2 (A), J7.2
/POWER/POWER_GOOD: R34.1, TP5.1, U2.8 (PG)
/POWER/VIN_PROT: C33.1, D12.1 (K), D13.1 (K), R31.2, TP4.1, U2.2 (VIN)
GND: C33.2, C34.2, C35.2, C36.2, J7.1, J10.2, R33.2, U2.1 (PGND), U2.4 (AGND), U2.9 (PAD), U3.2 (GND); also elsewhere on the board
unnamed: R31.1, U2.3 (EN)
unnamed: R32.2, R33.1, TP6.1, U2.5 (FB)
unnamed: L2.1, U2.7 (SW)
unnamed: C34.1, L2.2, R32.1, R34.2, R35.2, R36.1, TP7.1, U2.6 (VOS)
unnamed: R38.1, U3.3 (EN)
unnamed: C35.1, R36.2, R37.2, R38.2, U3.1 (VIN)

Notes on the sheet:
Populate R32 and U5 for LDO only operation and no battery input Populate R33 for Buck only Populate R31 and U5 for Buck and LDO operation
Alternative Wired Power Source for Card
AUX POWER
R1 = R2(Vout/0.8-1) R1 = 625k for 3.3Vout R1 = 800k for 4vout
LAYOUT: FOLLOW DATASHEET
Max current 0.2A Input voltage 5-8V Peak to peak L current: 0.39167A @2.25MHz Max L current: 0.39584A
Rds(on) HS = 600m Vin(min) = Vout(min) + Iout(Rds(on) + RL) RL must be less than 7.9R

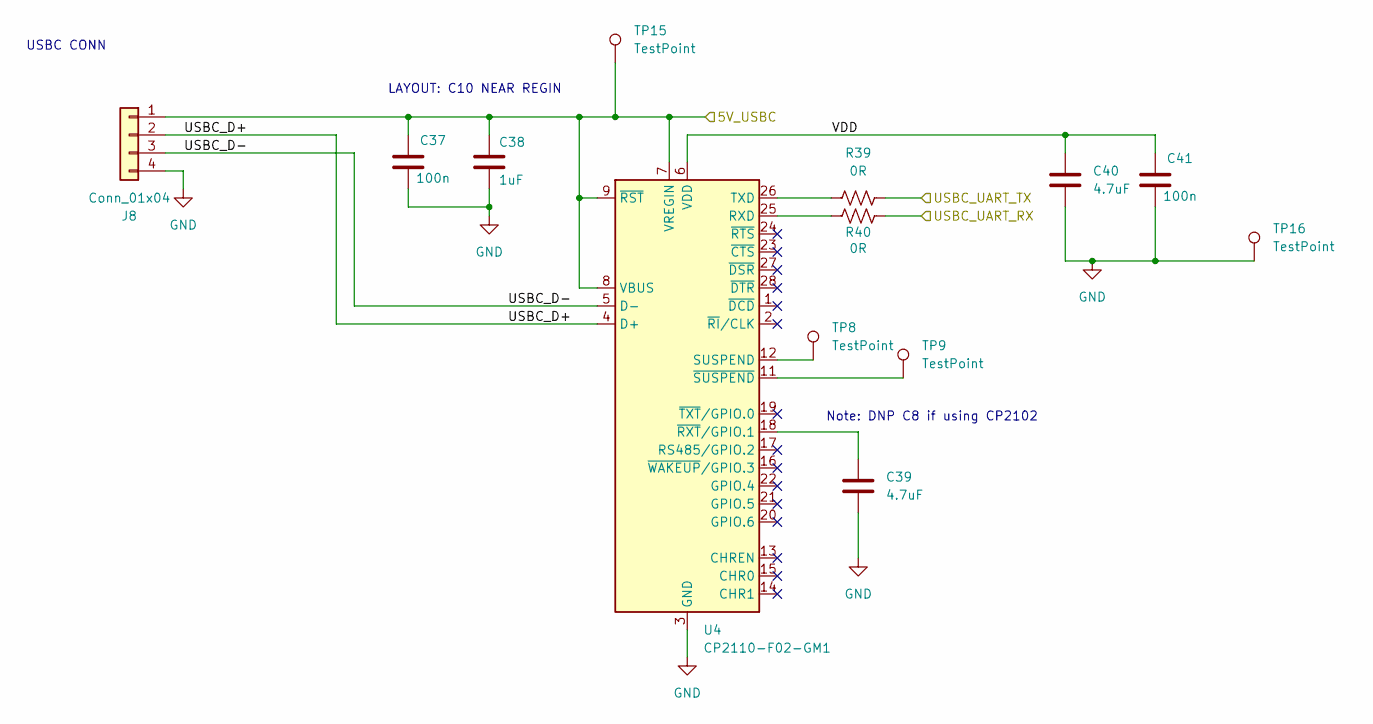
[picture p14: schematic USBC_TO_UART.kicad_sch]

Parts:
C37, C41: 100n; C_0603_1608Metric_Pad1.08x0.95mm_HandSolder; Part Number CC0603KRX7R7BB104
C38: 1uF; C_0603_1608Metric_Pad1.08x0.95mm_HandSolder; Part Number CC0603KRX5R8BB105
C39, C40: 4.7uF; C_0603_1608Metric_Pad1.08x0.95mm_HandSolder; Part Number CL10A475KP8NNNC
J8: Conn_01x04; PinHeader_1x04_P2.54mm_Horizontal; Part Number 61300411121
R39, R40: 0R; R_0603_1608Metric_Pad0.98x0.95mm_HandSolder; MANUFACTURER PART NUMBER RC0603JR-070RL; Digikey Part Number 311-0.0GRTR-ND
TP8, TP9, TP15, TP16: TestPoint; TestPoint_Pad_D3.0mm
U4: CP2110-F02-GM1; QFN-28-1EP_5x5mm_P0.5mm_EP3.35x3.35mm; Part Number CP2110-F02-GM1

Connections:
/MCU/USBC_UART_RX: R40.2; also elsewhere on the board
/MCU/USBC_UART_TX: R39.2; also elsewhere on the board
/POWER/5V_USBC: C37.1, C38.1, J8.1, TP15.1, U4.7 (VREGIN), U4.8 (VBUS), U4.9 (~RST); also elsewhere on the board
/USBC_TO_UART/USBC_D+: J8.2, U4.4 (D+)
/USBC_TO_UART/USBC_D-: J8.3, U4.5 (D-)
/USBC_TO_UART/VDD: C40.1, C41.1, U4.6 (VDD)
GND: C37.2, C38.2, C39.2, C40.2, C41.2, J8.4, TP16.1, U4.3 (GND), U4.29 (GND); also elsewhere on the board
unnamed: R40.1, U4.25 (RXD)
unnamed: TP8.1, U4.12 (SUSPEND)
unnamed: R39.1, U4.26 (TXD)
unnamed: C39.1, U4.18 (~RXT/GPIO.1)
unnamed: TP9.1, U4.11 (~SUSPEND)

Notes on the sheet:
USBC CONN
Note: DNP C8 if using CP2102
LAYOUT: C10 NEAR REGIN

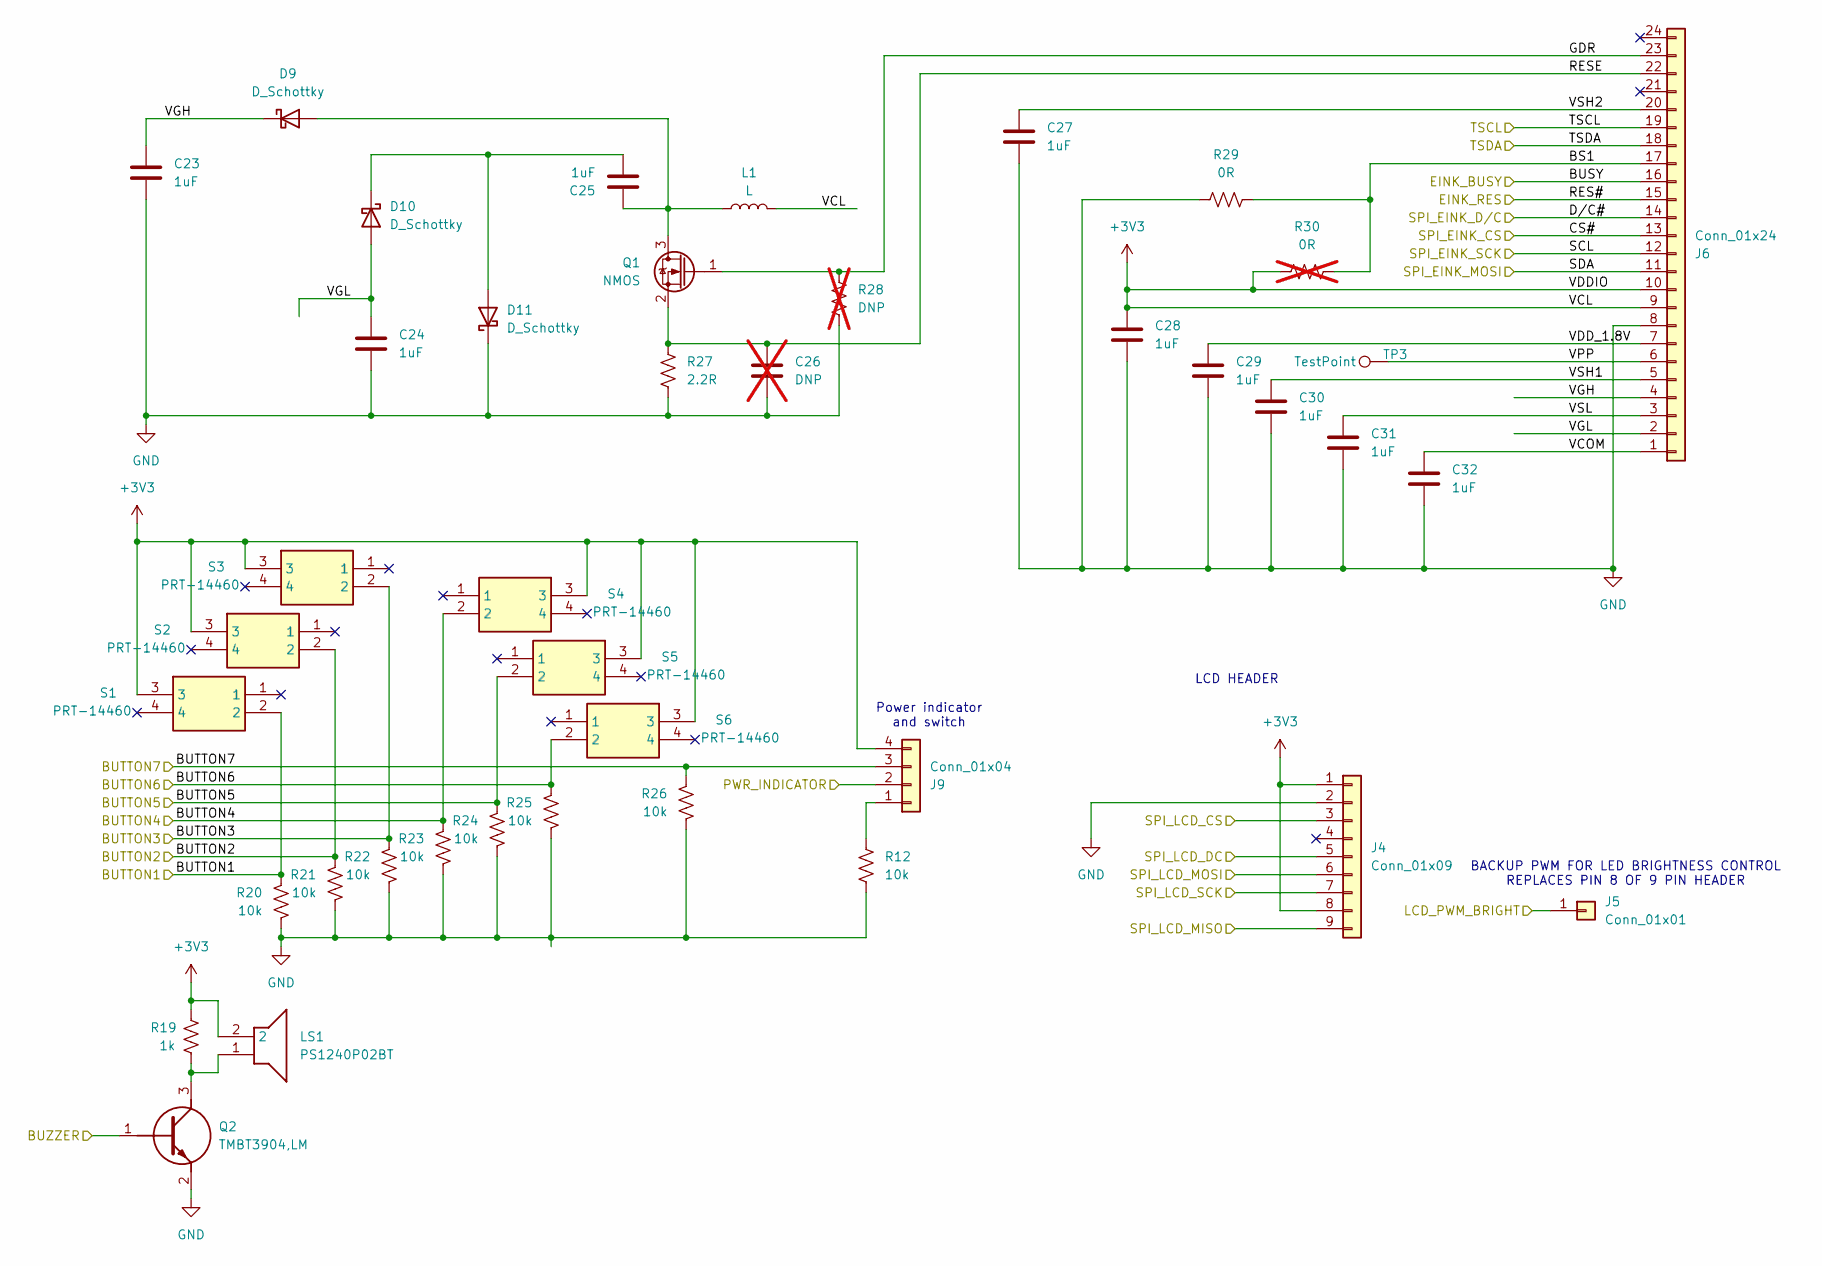
[picture p15: schematic INTERFACE.kicad_sch]

Parts:
C23, C24, C25, C27, C28, C29, C30, C31, C32: 1uF; C_0603_1608Metric_Pad1.08x0.95mm_HandSolder; MANUFACTURER PART NUMBER CC0603KRX5R8BB105; Digikey Part Number 311-1445-2-ND
C26: DNP; C_0603_1608Metric_Pad1.08x0.95mm_HandSolder; MANUFACTURER PART NUMBER 100pF; not fitted
D9, D10, D11: D_Schottky; D_SOD-123; MANUFACTURER PART NUMBER MBR0530T1G; Digikey Part Number MBR0530T1GOSTR-ND
J4: Conn_01x09; PinHeader_1x09_P2.54mm_Horizontal; Part Number 61300911121
J5: Conn_01x01; PinHeader_1x01_P2.54mm_Horizontal; Part Number 61300111121
J6: Conn_01x24; TE_2-1734839-4_1x24-1MP_P0.5mm_Horizontal; MANUFACTURER PART NUMBER 10051922-2410ELF
J9: Conn_01x04; PinHeader_1x04_P2.54mm_Horizontal; Part Number 61300411121
L1: L; CDRH5D18; MANUFACTURER PART NUMBER CDRH5D18NP-470NC; Digikey Part Number 308-2060-2-ND
LS1: PS1240P02BT; Mouser Part Number 810-PS1240P02BT
Q1: NMOS; SOT-23; MANUFACTURER PART NUMBER IRLML2803TRPBF; Digikey Part Number IRLML2803PBFTR-ND
Q2: TMBT3904,LM; TMBT3904LM; Mouser Part Number 757-TMBT3904LM
R12, R20, R21, R22, R23, R24, R25, R26: 10k; R_0603_1608Metric_Pad0.98x0.95mm_HandSolder; Part Number RC0603FR-0710KL
R19: 1k; R_0603_1608Metric_Pad0.98x0.95mm_HandSolder; Part Number RC0603FR-071KL
R27: 2.2R; R_0603_1608Metric_Pad0.98x0.95mm_HandSolder; MANUFACTURER PART NUMBER RC0603FR-072R2L; Digikey Part Number 311-2.2HRTR-ND
R28: DNP; R_0603_1608Metric_Pad0.98x0.95mm_HandSolder; MANUFACTURER PART NUMBER 100kR; not fitted
R29: 0R; R_0603_1608Metric_Pad0.98x0.95mm_HandSolder; MANUFACTURER PART NUMBER RC0603JR-070RL; Digikey Part Number 311-0.0GRTR-ND
R30: 0R; R_0603_1608Metric_Pad0.98x0.95mm_HandSolder; MANUFACTURER PART NUMBER RC0603JR-070RL; Digikey Part Number 311-0.0GRTR-ND; not fitted
S1, S2, S3, S4, S5, S6: PRT-14460; PRT14460; Mouser Part Number 474-PRT-14460
TP3: TestPoint; TestPoint_Pad_D3.0mm

Connections:
+3V3: C28.1, J4.1, J4.8, J6.9, J6.10, J9.4, L1.2, LS1.2, R19.1, R30.1, S1.3, S2.3, S3.3, S4.3, S5.3, S6.3; also elsewhere on the board
/INTERFACE/BS1: J6.17, R29.2, R30.2
/INTERFACE/BUSY: J6.16; also elsewhere on the board
/INTERFACE/BUTTON1: R20.1, S1.2; also elsewhere on the board
/INTERFACE/BUTTON2: R21.1, S2.2; also elsewhere on the board
/INTERFACE/BUTTON3: R22.1, S3.2; also elsewhere on the board
/INTERFACE/BUTTON4: R23.1, S4.2; also elsewhere on the board
/INTERFACE/BUTTON5: R24.1, S5.2; also elsewhere on the board
/INTERFACE/BUTTON6: R25.1, S6.2; also elsewhere on the board
/INTERFACE/BUTTON7: J9.3, R26.1; also elsewhere on the board
/INTERFACE/BUZZER: Q2.1 (B); also elsewhere on the board
/INTERFACE/CS#: J6.13; also elsewhere on the board
/INTERFACE/D/C#: J6.14; also elsewhere on the board
/INTERFACE/GDR: J6.23, Q1.1 (G), R28.1
/INTERFACE/LCD_PWM_BRIGHT: J5.1; also elsewhere on the board
/INTERFACE/RES#: J6.15; also elsewhere on the board
/INTERFACE/RESE: C26.1, J6.22, Q1.2 (S), R27.1
/INTERFACE/SCL: J6.12; also elsewhere on the board
/INTERFACE/SDA: J6.11; also elsewhere on the board
/INTERFACE/TSCL: J6.19
/INTERFACE/TSDA: J6.18
/INTERFACE/VCOM: C32.1, J6.1
/INTERFACE/VDD_1.8V: C29.1, J6.7
/INTERFACE/VGH: C23.1, D9.1 (K), J6.4
/INTERFACE/VGL: C24.1, D10.2 (A), J6.2
/INTERFACE/VPP: J6.6, TP3.1
/INTERFACE/VSH1: C30.1, J6.5
/INTERFACE/VSH2: C27.1, J6.20
/INTERFACE/VSL: C31.1, J6.3
/MCU/PWR_INDICATOR: J9.2; also elsewhere on the board
/MCU/SPI_LCD_CS: J4.3; also elsewhere on the board
/MCU/SPI_LCD_DC: J4.5; also elsewhere on the board
/MCU/SPI_LCD_MISO: J4.9; also elsewhere on the board
/MCU/SPI_LCD_MOSI: J4.6; also elsewhere on the board
/MCU/SPI_LCD_SCK: J4.7; also elsewhere on the board
GND: C23.2, C24.2, C26.2, C27.2, C28.2, C29.2, C30.2, C31.2, C32.2, D11.1 (K), J4.2, J6.8, Q2.2 (E), R12.2, R20.2, R21.2, R22.2, R23.2, R24.2, R25.2, R26.2, R27.2, R28.2, R29.1; also elsewhere on the board
unnamed: C25.1, D9.2 (A), L1.1, Q1.3 (D)
unnamed: C25.2, D10.1 (K), D11.2 (A)
unnamed: J9.1, R12.1
unnamed: LS1.1, Q2.3 (C), R19.2

Notes on the sheet:
Power indicator and switch
LCD HEADER
BACKUP PWM FOR LED BRIGHTNESS CONTROL REPLACES PIN 8 OF 9 PIN HEADER

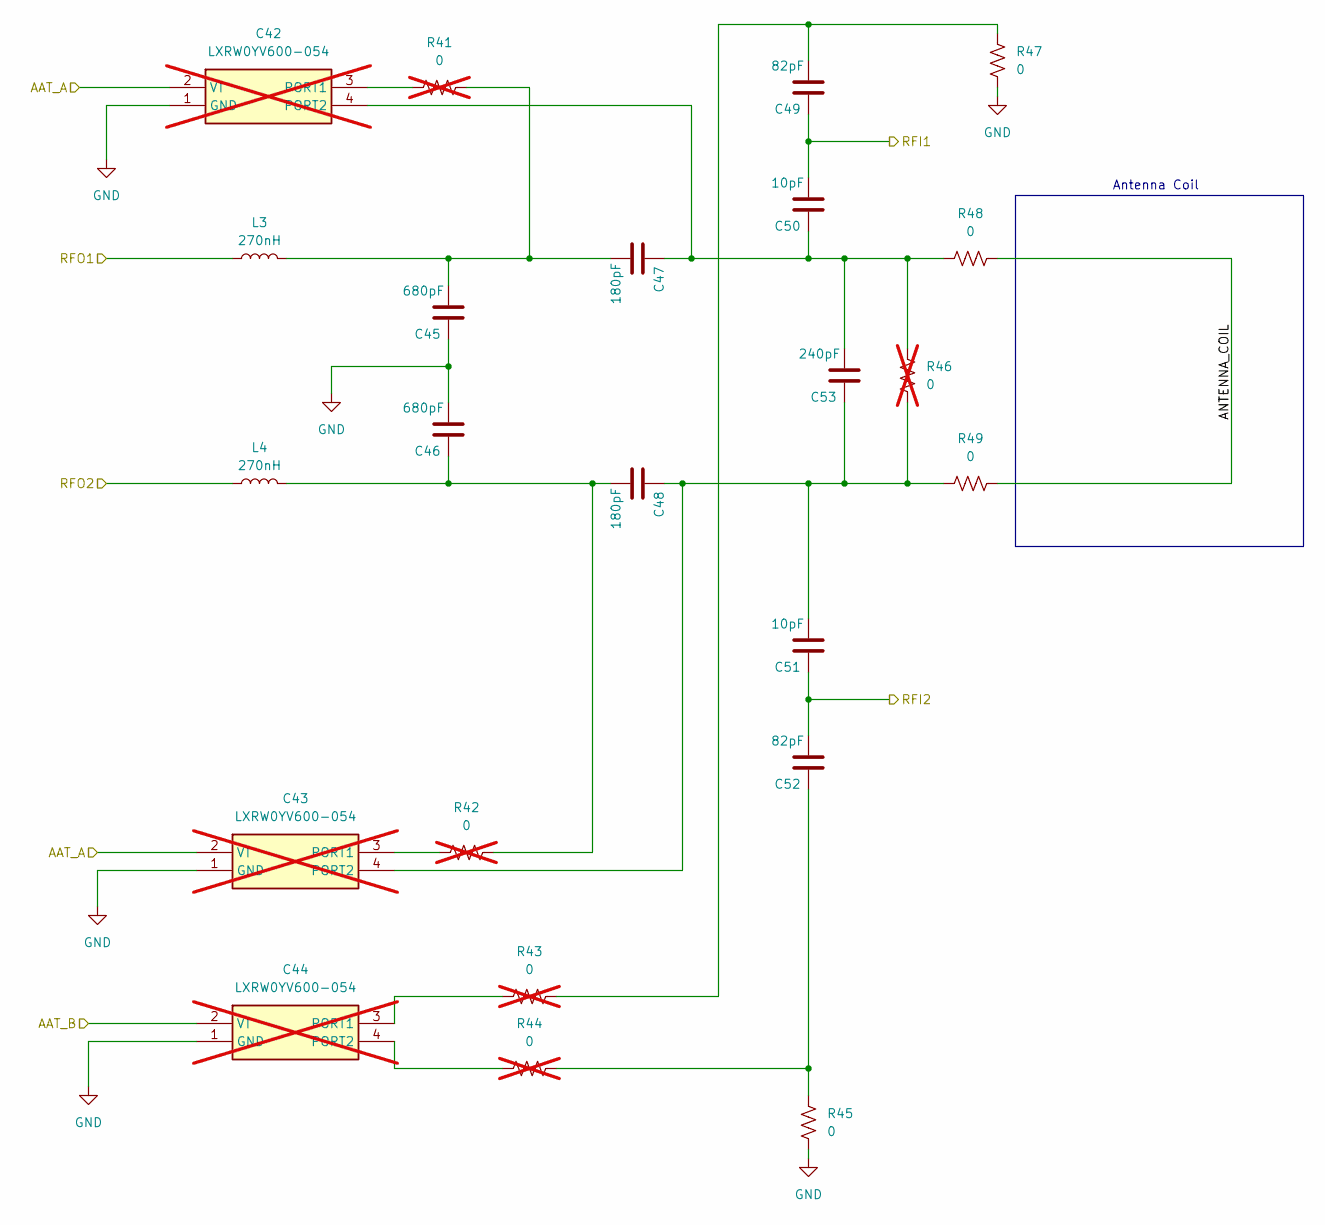
[picture p16: schematic antenna.kicad_sch]

Parts:
C42, C43, C44: LXRW0YV600-054; LXRW0YV600054; Mouser Part Number 81-LXRW0YV600-054; not fitted
C45, C46: 680pF; C_0603_1608Metric_Pad1.08x0.95mm_HandSolder; MANUFACTURER PART NUMBER CC0603KRX5R8BB105; Digikey Part Number 311-1445-2-ND
C47, C48: 180pF; C_0603_1608Metric_Pad1.08x0.95mm_HandSolder; MANUFACTURER PART NUMBER CC0603KRX5R8BB105; Digikey Part Number 311-1445-2-ND
C49, C52: 82pF; C_0603_1608Metric_Pad1.08x0.95mm_HandSolder; MANUFACTURER PART NUMBER CC0603KRX5R8BB105; Digikey Part Number 311-1445-2-ND
C50, C51: 10pF; C_0603_1608Metric_Pad1.08x0.95mm_HandSolder; MANUFACTURER PART NUMBER CC0603KRX5R8BB105; Digikey Part Number 311-1445-2-ND
C53: 240pF; C_0603_1608Metric_Pad1.08x0.95mm_HandSolder; MANUFACTURER PART NUMBER CC0603KRX5R8BB105; Digikey Part Number 311-1445-2-ND
L3, L4: 270nH; L_0603_1608Metric; MANUFACTURER PART NUMBER CDRH5D18NP-470NC; Digikey Part Number 308-2060-2-ND
R41, R42, R43, R44, R46: 0; R_0603_1608Metric_Pad0.98x0.95mm_HandSolder; MANUFACTURER PART NUMBER CRCW0603590RFKEA; Digikey Part Number 541-590HTR-ND; not fitted
R45, R47, R48, R49: 0; R_0603_1608Metric_Pad0.98x0.95mm_HandSolder; MANUFACTURER PART NUMBER CRCW0603590RFKEA; Digikey Part Number 541-590HTR-ND

Connections:
/NFC/ANTENNA/AAT_A: C42.2 (VT), C43.2 (VT); also elsewhere on the board
/NFC/ANTENNA/AAT_B: C44.2 (VT); also elsewhere on the board
/NFC/ANTENNA/ANTENNA_COIL: R48.2, R49.2
/NFC/ANTENNA/RFI1: C49.1, C50.2; also elsewhere on the board
/NFC/ANTENNA/RFI2: C51.1, C52.2; also elsewhere on the board
/NFC/ANTENNA/RFO1: L3.1; also elsewhere on the board
/NFC/ANTENNA/RFO2: L4.1; also elsewhere on the board
GND: C42.1 (GND), C43.1 (GND), C44.1 (GND), C45.1, C46.2, R45.2, R47.2; also elsewhere on the board
unnamed: C42.3 (PORT1), R41.1
unnamed: C42.4 (PORT2), C47.1, C50.1, C53.2, R46.2, R48.1
unnamed: C43.3 (PORT1), R42.1
unnamed: C43.4 (PORT2), C48.1, C51.2, C53.1, R46.1, R49.1
unnamed: C44.3 (PORT1), R43.1
unnamed: C44.4 (PORT2), R44.1
unnamed: C45.2, C47.2, L3.2, R41.2
unnamed: C46.1, C48.2, L4.2, R42.2
unnamed: C49.2, R43.2, R47.1
unnamed: C52.1, R44.2, R45.1

Notes on the sheet:
Antenna Coil

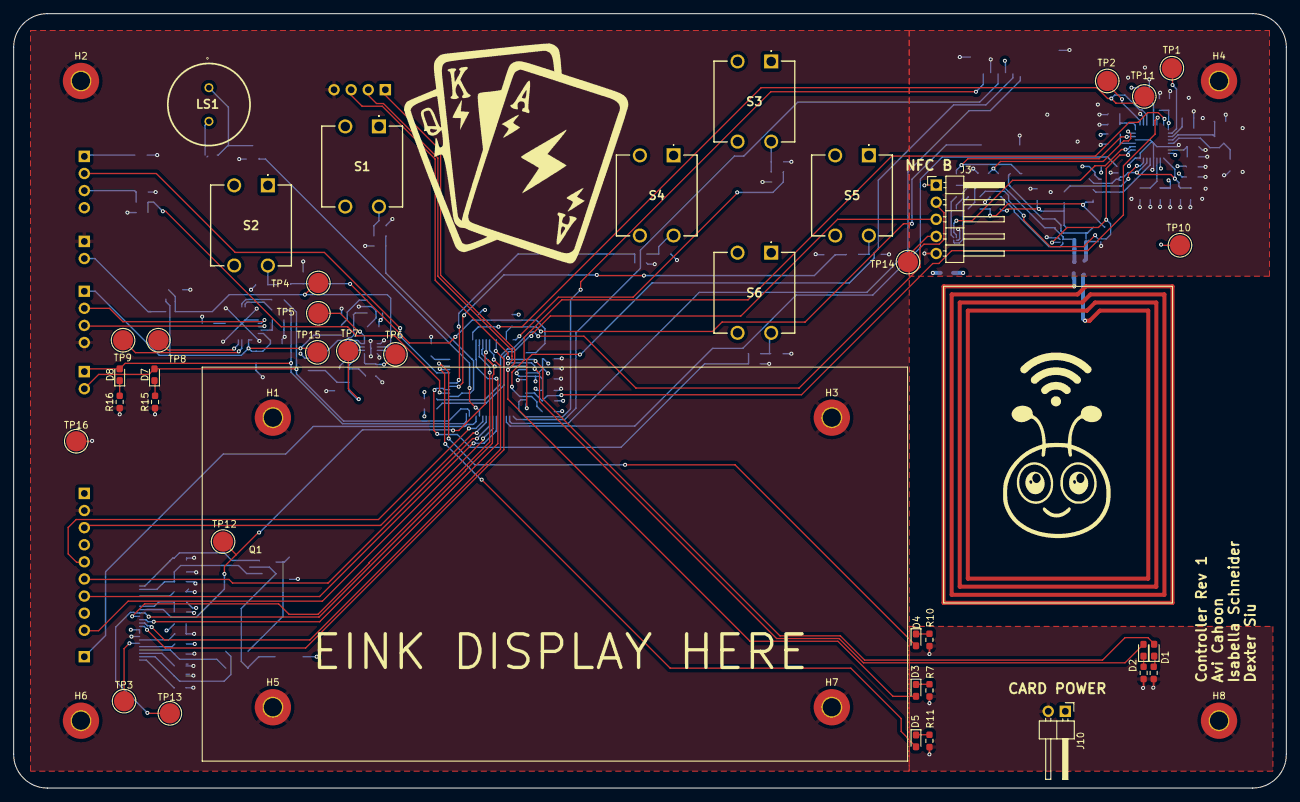
[picture p17: board Ecardz-Controller.kicad_pcb from above]

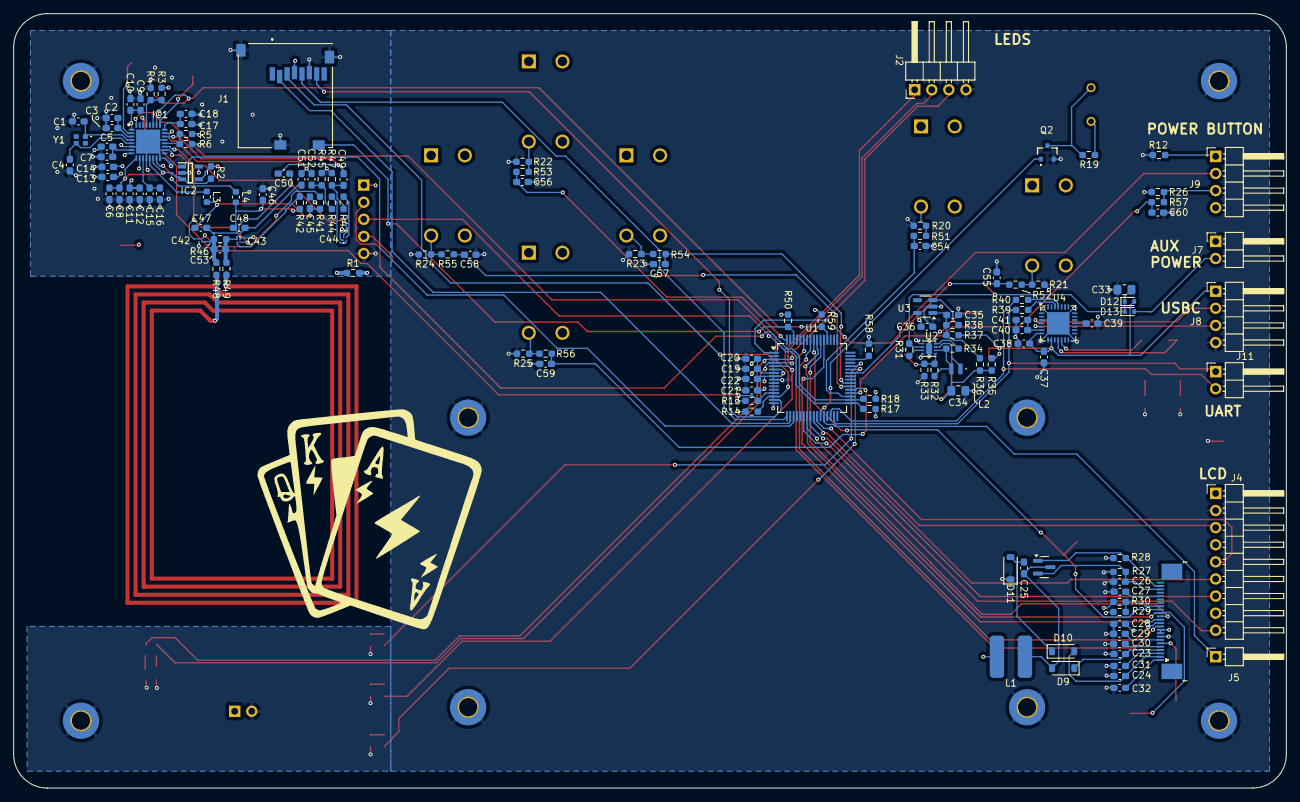
[picture p18: board Ecardz-Controller.kicad_pcb from below]

Board: 4 copper layers, 189.0 x 115.0 mm, 186 parts (139 on the bottom side), 119 nets.
