mte-capstone-ecards/Ecardz-EE/Ecardz-Proto/Ecardz-Proto.kicad_pcb

## KiCad design Ecardz-Proto/Ecardz-Proto.kicad_pcb (2024-11-13, an earlier design)

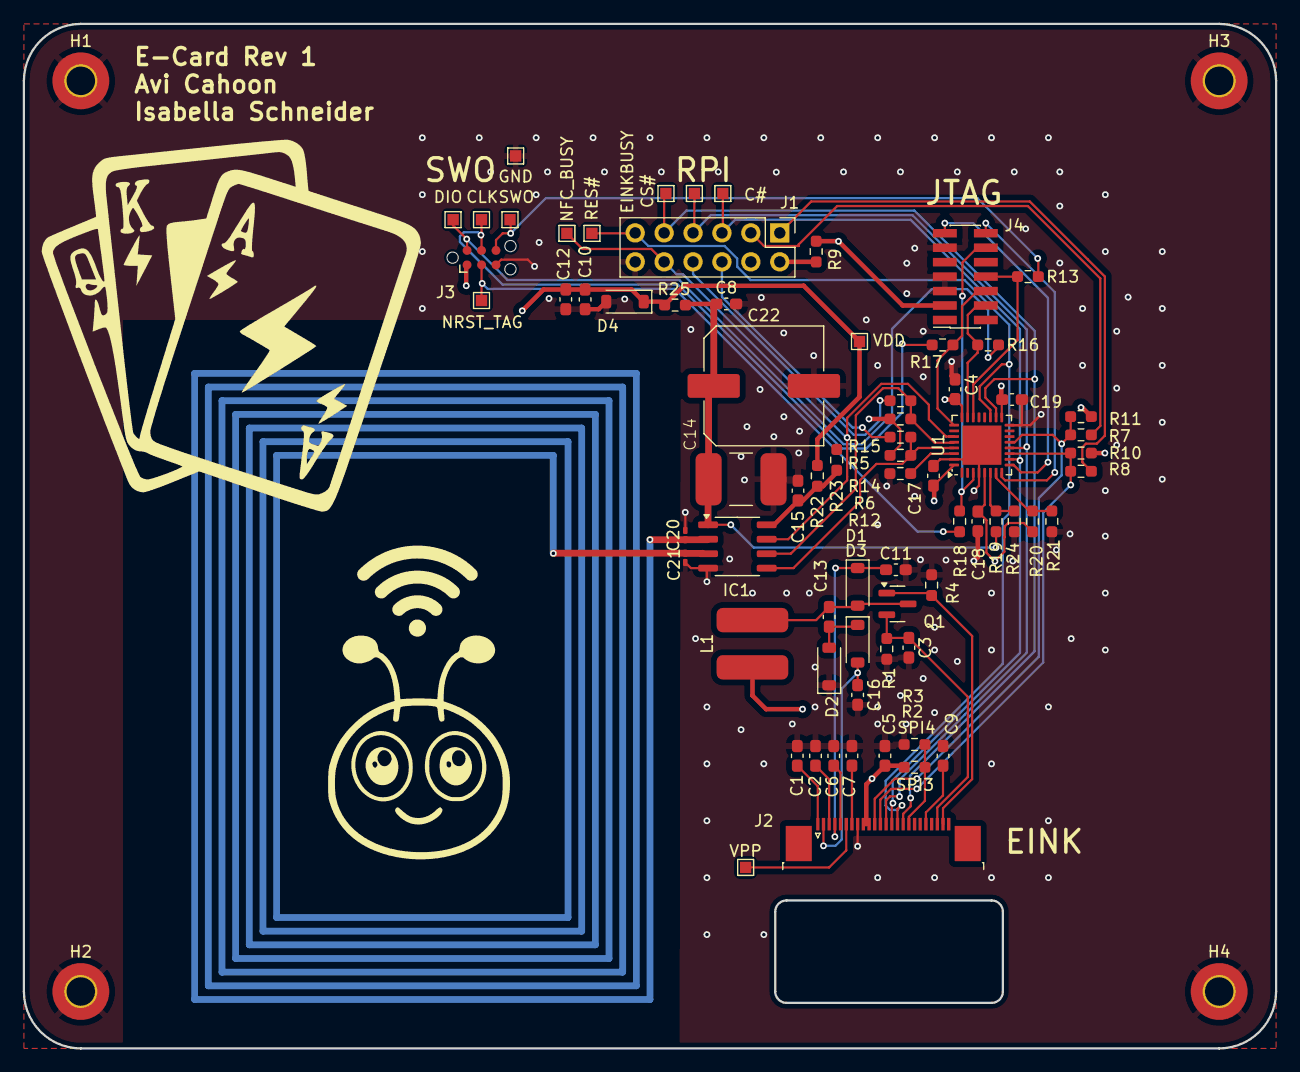
[picture p19: board Ecardz-Proto/Ecardz-Proto.kicad_pcb from above]

Board: 4 copper layers, 110.0 x 90.0 mm, 75 parts (0 on the bottom side), 45 nets.

Parts:
C1, C2, C4, C5, C6, C7, C9, C11, C13, C16, C17, C18, C19: 1uF; C_0603_1608Metric_Pad1.08x0.95mm_HandSolder
C3: DNP; C_0603_1608Metric_Pad1.08x0.95mm_HandSolder
C8, C10, C12: TBD; C_0603_1608Metric_Pad1.08x0.95mm_HandSolder
C14: TBD; C_2917
C15: 10nF; C_0603_1608Metric_Pad1.08x0.95mm_HandSolder
C20, C21: 7pF; C_0201_0603Metric_Pad0.64x0.40mm_HandSolder
C22: TBD; C_Elec_10x10.2
C#: TestPoint; TestPoint_Pad_1.0x1.0mm
CLK: TestPoint; TestPoint_Pad_1.0x1.0mm
CS#: TestPoint; TestPoint_Pad_1.0x1.0mm
D1, D2, D3: D_Schottky; D_SOD-123
D4: D_Zener; D_SOD-123
DIO: TestPoint; TestPoint_Pad_1.0x1.0mm
EINKBUSY: TestPoint; TestPoint_Pad_1.0x1.0mm
GND: TestPoint; TestPoint_Pad_1.0x1.0mm
H1, H2, H3, H4: MountingHole_Pad; MountingHole_2.5mm_Pad_TopBottom
IC1: M24LR04E-RMN6T/2; SO-8_3.9x4.9mm_P1.27mm
J1: Conn_02x06_Odd_Even; PinHeader_2x06_P2.54mm_Vertical
J2: Conn_01x24; TE_2-1734839-4_1x24-1MP_P0.5mm_Horizontal
J3: Conn_ARM_SWD_TagConnect_TC2030-NL; Tag-Connect_TC2030-IDC-NL_2x03_P1.27mm_Vertical
J4: Conn_02x07_Odd_Even; PinSocket_2x07_P1.27mm_Vertical_SMD
L1: L; CDRH5D18
NFC_BUSY: TestPoint; TestPoint_Pad_1.0x1.0mm
NRST_TAG: TestPoint; TestPoint_Pad_1.0x1.0mm
Q1: NMOS; SOT-23
R1: 2.2R; R_0603_1608Metric_Pad0.98x0.95mm_HandSolder
R2, R3: 0R; R_0603_1608Metric_Pad0.98x0.95mm_HandSolder
R4, R5, R6, R7, R8, R9, R10, R11, R12, R13, R14, R15, R16, R17, R18, R22, R23: DNP; R_0603_1608Metric_Pad0.98x0.95mm_HandSolder
R19, R20, R21, R24: 10k; R_0603_1608Metric_Pad0.98x0.95mm_HandSolder
R25: 600R; R_0603_1608Metric_Pad0.98x0.95mm_HandSolder
RES#: TestPoint; TestPoint_Pad_1.0x1.0mm
SWO: TestPoint; TestPoint_Pad_1.0x1.0mm
U1: STM32L071K8Ux; QFN-32-1EP_5x5mm_P0.5mm_EP3.45x3.45mm
VDD: TestPoint; TestPoint_Pad_1.0x1.0mm
VPP: TestPoint; TestPoint_Pad_1.0x1.0mm

Connections:
+3.3V: J1.2, R9.2
/EINK/BS1: J2.17, R2.2, R3.2
/EINK/BUSY: EINKBUSY.1, J1.9, J2.16, U1.18 (PA8)
/EINK/CS#: CS#.1, J1.7, J2.13, U1.12 (PA6)
/EINK/D/C#: C#.1, J1.5, J2.14, U1.10 (PA4)
/EINK/GDR: J2.23, Q1.1 (G), R4.1
/EINK/RES#: J1.11, J2.15, RES#.1, U1.19 (PA9)
/EINK/RESE: C3.1, J2.22, Q1.2 (S), R1.1
/EINK/SCL: J2.12, R8.2, R10.1, U1.11 (PA5)
/EINK/SDA: J2.11, R7.2, R11.1, U1.13 (PA7)
/EINK/VCOM: C1.1, J2.1
/EINK/VDD_1.8V: C7.1, J2.7
/EINK/VGH: C11.1, D1.1 (K), J2.4
/EINK/VGL: C16.1, D3.2 (A), J2.2
/EINK/VPP: J2.6, VPP.1
/EINK/VSH1: C6.1, J2.5
/EINK/VSH2: C9.1, J2.20
/EINK/VSL: C2.1, J2.3
/NFC/VDD_NFC: C15.1, IC1.8 (VCC), R22.1, R23.1
/NFC/V_E_HARVEST: C8.1, C14.1, C22.1, IC1.1 (VOUT), R19.1, R25.1
/STM/BOOT0: R12.2, U1.30 (BOOT0)
/STM/I2C_NFC_SCL: IC1.6 (SCL), R5.2, R15.2, U1.28 (PB6)
/STM/I2C_NFC_SCL_RPI: J1.8, R15.1
/STM/I2C_NFC_SDA: IC1.5 (SDA), R6.2, R14.2, U1.29 (PB7)
/STM/I2C_NFC_SDA_RPI: J1.6, R14.1
/STM/NFC_BUSY: IC1.7 (RF_WIP/BUSY), J1.10, NFC_BUSY.1, U1.27 (PB5)
/STM/NRST: J4.12, R18.2, U1.3 (NRST)
/STM/NRST_TAG: J3.3 (~RESET), NRST_TAG.1, R18.1
/STM/SPI_EINK_SCL_RPI: J1.1, R10.2
/STM/SPI_EINK_SDA_RPI: J1.3, R11.2
/STM/SWCLK: J4.6, R17.1, U1.25 (PA14)
/STM/SWCLK_TAG: CLK.1, J3.4 (SWCLK), R17.2
/STM/SWDIO: J4.4, R16.1, U1.23 (PA13)
/STM/SWDIO_TAG: DIO.1, J3.2 (SWDIO), R16.2
/STM/SWO: J4.8, R13.1, U1.22 (PA12)
/STM/SWO_TAG: J3.6 (SWO), R13.2, SWO.1
/STM/T_VCP_RX: J4.13, U1.9 (PA3)
/STM/T_VCP_TX: J4.14, U1.8 (PA2)
/STM/VDD_MEAS: R20.2, R21.1, U1.7 (PA1)
GND: C1.2, C2.2, C3.2, C4.1, C5.2, C6.2, C7.2, C8.2, C9.2, C10.2, C11.2, C12.2, C14.2, C15.2, C16.2, C17.1, C18.1, C19.1, C20.2, C21.2, C22.2, D2.1 (K), D4.2 (A), GND.1, H1.1, H2.1, H3.1, H4.1, IC1.4 (VSS), J1.12, J2.8, J3.5 (GND), J4.5, J4.7, J4.11, R1.2, R3.1, R4.2, R12.1, R21.2, R24.2, U1.4 (VSSA), U1.16 (VSS), U1.31 (VSS), U1.33 (VSS)
unnamed: C13.1, D1.2 (A), L1.1, Q1.3 (D)
unnamed: C13.2, D2.2 (A), D3.1 (K)
unnamed: C20.1, C21.1, IC1.2 (AC0), IC1.3 (AC1)
unnamed: R19.2, R24.1, U1.6 (PA0)
VDD: C4.2, C5.1, C10.1, C12.1, C17.2, C18.2, C19.2, D4.1 (K), J2.9, J2.10, J3.1 (VCC), J4.3, L1.2, R2.1, R5.1, R6.1, R7.1, R8.1, R9.1, R20.1, R22.2, R25.2, U1.5 (VDDA), U1.17 (VDD), U1.24 (VDDIO2), U1.32 (VDD), VDD.1
