mte-capstone-ecards/Ecardz-EE/(commit log)

2024-05-08 new project doc
    [NFC_DEV.PrjPcb, Schlib1.SchLib, Sheet1.SchDoc]
2024-05-08 just kidding we gonna use kicad
    [NFC_DEV.PrjPcb, Schlib1.SchLib, Sheet1.SchDoc]
2024-06-27 New kicad project
    added kicad project and EINK interface
    [EINK.kicad_sch, Ecardz-Proto.kicad_pcb, Ecardz-Proto.kicad_sch, NFC.kicad_sch, STM.kicad_sch]
2024-10-07 added EEPROM schematic, removed personal files
    [EEPROM.kicad_sch, Ecardz-Proto.kicad_sch]
2024-10-26 added energy harvesting schematic page
    [Ecardz-Proto.kicad_sch]
2024-10-26 upated E-ink schematic
    should be done - just missing inductor footprint
    [EINK.kicad_sch]
2024-10-29 added energy harvesting sensing ADC to NFC
    [Ecardz-Proto.kicad_sch, NFC.kicad_sch, energyharvesting.kicad_sch]
2024-11-04 removed eeprom
    [Ecardz-Proto.kicad_sch]
2024-11-06 added STM and rpi pin connections.
    [EINK.kicad_sch, Ecardz-Proto.kicad_sch, NFC.kicad_sch, STM.kicad_sch]
2024-11-09 updated STM pinout
    Updated RPI to just be breakout headers
    Added JTAG connector and LPUSART
    Updated to final? STM pinout
    [STM.kicad_sch]
2024-11-09 added VDD cap
    [STM.kicad_sch]
2024-11-09 made all supply voltages VDD rather than mix of VDD/VCC, added VDD measurement via STM32 internal ADC, put DNP jumper for VPP on E-ink connector, and made NFC VCC pin only connected to power if exter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
    [EINK.kicad_sch, NFC.kicad_sch, STM.kicad_sch]
2024-11-09 added jumpers to select NFC chip's power supply connection
    [NFC.kicad_sch, STM.kicad_sch]
2024-11-10 updated most footprints
    [Ecardz-Proto.kicad_pcb, Ecardz-Proto.kicad_sch, NFC.kicad_sch, STM.kicad_sch]
2024-11-10 board outline
    [EINK.kicad_sch, Ecardz-Proto.kicad_pcb, STM.kicad_sch]
2024-11-10 added a C_2917 cap to NFC energy harvesting in case needed
    [NFC.kicad_sch]
2024-11-10 added antenna tuning caps
    [Ecardz-Proto.kicad_pcb, NFC.kicad_sch]
2024-11-10 rough layout complete
    need to fix silkscreens and finish antenna
    [Ecardz-Proto.kicad_pcb, NFC.kicad_sch, STM.kicad_sch]
2024-11-11 fit layout in 4.2in card size
    [Ecardz-Proto.kicad_pcb]
2024-11-11 added more space around antenna
    [Ecardz-Proto.kicad_pcb]
2024-11-11 added large cap to layout
    [Ecardz-Proto.kicad_pcb]
2024-11-12 added zener and extra cap footprints
    [Ecardz-Proto.kicad_pcb, Ecardz-Proto.kicad_sch, NFC.kicad_sch, STM.kicad_sch]
2024-11-12 updated inductor
    [EINK.kicad_sch, Ecardz-Proto.kicad_pcb]
2024-11-12 updated silkscreen
    [Ecardz-Proto.kicad_pcb]
2024-11-12 silkscreen images
    and fixed layout DRCs
    [Ecardz-Proto.kicad_pcb]
2024-11-13 gerbers generated for first fab
    [Ecardz-Proto-B_Cu.gbr, Ecardz-Proto-B_Mask.gbr, Ecardz-Proto-B_Paste.gbr, Ecardz-Proto-B_Silkscreen.gbr, Ecardz-Proto-Edge_Cuts.gbr, Ecardz-Proto-F_Cu.gbr, Ecardz-Proto-F_Mask.gbr, Ecardz-Proto-F_Paste.gbr]
2024-11-13 added stitching vias
    [Ecardz-Proto.kicad_pcb]
2024-11-13 final gerbers for first fab
    [Ecardz-Proto-B_Cu.gbr, Ecardz-Proto-B_Mask.gbr, Ecardz-Proto-B_Paste.gbr, Ecardz-Proto-B_Silkscreen.gbr, Ecardz-Proto-Edge_Cuts.gbr, Ecardz-Proto-F_Cu.gbr, Ecardz-Proto-F_Mask.gbr, Ecardz-Proto-F_Paste.gbr]
2024-11-15 added parts numbers for everything
    [EINK.kicad_sch, Ecardz-Proto.kicad_sch, NFC.kicad_sch, STM.kicad_sch]
2024-11-20 new controller schematic
    [Ecardz-Controller.kicad_pcb, Ecardz-Controller.kicad_sch, INTERFACE.kicad_sch, MCU.kicad_sch, NFC.kicad_sch, POWER.kicad_sch, USBC_TO_UART.kicad_sch]
2024-12-19 added buck converter
    just missing inductor part selection
    [POWER.kicad_sch]
2024-12-22 adding MCU
    added peripheral connections as well as indicator lights
    [MCU.kicad_sch, POWER.kicad_sch, USBC_TO_UART.kicad_sch]
2024-12-22 updated button pin choices, updated root
    [Ecardz-Controller.kicad_sch, MCU.kicad_sch, NFC.kicad_sch, USBC_TO_UART.kicad_sch]
2025-01-06 usb to uart chip
    currently using the wrong kicad part number but they are footprint compatible
    [USBC_TO_UART.kicad_sch]
2025-01-06 small updates
    added 0 ohm on uart, more caps on power pins
    [USBC_TO_UART.kicad_sch]
2025-01-06 added eink and lcd pinouts
    [Ecardz-Controller.kicad_sch, INTERFACE.kicad_sch, MCU.kicad_sch]
2025-01-06 finished buzzer and button connections
    [INTERFACE.kicad_sch, MCU.kicad_sch]
2025-01-06 added NFC schematic
    [NFC.kicad_sch, antenna.kicad_sch]
2025-01-06 added SD card connector into parts-lib
2025-01-06 added LDO on buck output and SD card footprint
    [MCU.kicad_sch, POWER.kicad_sch]
2025-01-06 fixed FPC connector
    [INTERFACE.kicad_sch]
2025-01-07 updated for dxf
    [Ecardz-Controller.kicad_pcb]
2025-01-07 new card files
    [EEPROM.kicad_sch, EINK.kicad_sch, Ecardz-Proto.kicad_pcb, Ecardz-Proto.kicad_sch, NFC.kicad_sch, STM.kicad_sch, energyharvesting.kicad_sch]
2025-01-07 Started board layout + antenna
    [Ecardz-Proto-B_Cu.gbr, Ecardz-Proto-B_Mask.gbr, Ecardz-Proto-B_Paste.gbr, Ecardz-Proto-B_Silkscreen.gbr, Ecardz-Proto-Edge_Cuts.gbr, Ecardz-Proto-F_Cu.gbr, Ecardz-Proto-F_Mask.gbr, Ecardz-Proto-F_Paste.gbr]
2025-01-07 initial work on controller layout
    [Ecardz-Controller.kicad_pcb, Ecardz-Controller.kicad_sch, INTERFACE.kicad_sch, MCU.kicad_sch, NFC.kicad_sch, POWER.kicad_sch, USBC_TO_UART.kicad_sch, antenna.kicad_sch]
2025-01-09 did bulk of controller layout apart from the antenna, added some NCs and other minor clean ups on schematic
    [Ecardz-Controller.kicad_pcb, Ecardz-Controller.kicad_sch, INTERFACE.kicad_sch, MCU.kicad_sch, NFC.kicad_sch, POWER.kicad_sch, USBC_TO_UART.kicad_sch, antenna.kicad_sch]
2025-01-10 most of layout complete
    switched ADC pins for ease of layout. added LEDs
    [EINK.kicad_sch, Ecardz-Proto.kicad_pcb, NFC.kicad_sch, STM.kicad_sch]
2025-01-10 removed RPI header
    [Ecardz-Proto.kicad_pcb, STM.kicad_sch]
2025-01-10 controller updates
    [Ecardz-Controller.kicad_pcb, Ecardz-Controller.kicad_sch, INTERFACE.kicad_sch, MCU.kicad_sch, NFC.kicad_sch, POWER.kicad_sch, USBC_TO_UART.kicad_sch, antenna.kicad_sch]
2025-01-13 Added traces for everything but gruond layer
    [Ecardz-Proto.kicad_pcb]
2025-01-13 updates based on review
    [Ecardz-Controller.kicad_pcb, Ecardz-Controller.kicad_sch, MCU.kicad_sch, NFC.kicad_sch, POWER.kicad_sch]
2025-01-13 Finished all layout, need to fix inductor and capacitor library
    [Ecardz-Proto.kicad_pcb]
2025-01-14 added current sense resistor and modified buzzer circuit
    [Ecardz-Controller.kicad_pcb, Ecardz-Controller.kicad_sch, INTERFACE.kicad_sch, MCU.kicad_sch, NFC.kicad_sch]
2025-01-16 redid MCU connections from IOC file from FW team
    [Ecardz-Controller.kicad_sch, INTERFACE.kicad_sch, MCU.kicad_sch]
2025-01-16 updated layout for new mcu pin assignments
    [Ecardz-Controller.kicad_pcb, MCU.kicad_sch]
2025-01-16 slightly adjusted LED position
    [Ecardz-Controller.kicad_pcb]
2025-01-16 flipped SD card so it enters from card edge
    [Ecardz-Controller.kicad_pcb]
2025-01-16 changed headers to 90 degree angled headers
    [Ecardz-Controller.kicad_pcb, INTERFACE.kicad_sch, MCU.kicad_sch, POWER.kicad_sch, USBC_TO_UART.kicad_sch]
2025-01-17 moved headers to bottom of board, made J3 DNP
    [Ecardz-Controller.kicad_pcb, INTERFACE.kicad_sch, MCU.kicad_sch, NFC.kicad_sch, POWER.kicad_sch, USBC_TO_UART.kicad_sch, antenna.kicad_sch]
2025-01-19 changed hole positions and fixed flex connector location in 3d model
    [Ecardz-Controller.kicad_pcb, MCU.kicad_sch]
2025-01-19 placed button debouncing filter components in layout
    [Ecardz-Controller.kicad_pcb]
2025-01-20 final layout before fab
    [Ecardz-Controller.kicad_pcb, INTERFACE.kicad_sch, MCU.kicad_sch, NFC.kicad_sch, POWER.kicad_sch, USBC_TO_UART.kicad_sch]
2025-01-20 Generated gerbers
    [Ecardz-Controller-B_Cu.gbr, Ecardz-Controller-B_Mask.gbr, Ecardz-Controller-B_Paste.gbr, Ecardz-Controller-B_Silkscreen.gbr, Ecardz-Controller-Edge_Cuts.gbr, Ecardz-Controller-F_Cu.gbr, Ecardz-Controller-F_Mask.gbr, Ecardz-Controller-F_Paste.gbr]
2025-01-20 turned flex connector around
    [Ecardz-Controller.kicad_pcb]
2025-01-20 new gerbers with rotated FPC connector
    [Ecardz-Controller-B_Cu.gbr, Ecardz-Controller-B_Mask.gbr, Ecardz-Controller-B_Paste.gbr, Ecardz-Controller-B_Silkscreen.gbr, Ecardz-Controller-Edge_Cuts.gbr, Ecardz-Controller-F_Cu.gbr, Ecardz-Controller-F_Mask.gbr, Ecardz-Controller-F_Paste.gbr]
2025-02-18 final schematic
    final schematic done and BOM generated except for pogo pins and capacitors
    [EINK.kicad_sch, Ecardz-Proto-BOM.csv, Ecardz-Proto.kicad_pcb, Ecardz-Proto.kicad_sch, NFC.kicad_sch, STM.kicad_sch]
2025-02-22 initial fit check for mech
    final footprints defined and placement is mostly complete
    [EINK.kicad_sch, Ecardz-Proto.kicad_pcb, Ecardz-Proto.step, NFC.kicad_sch, STM.kicad_sch]
2025-02-22 added antenna jumpers
    [Ecardz-Proto.kicad_pcb, Ecardz-Proto.step, NFC.kicad_sch]
2025-02-23 second mech spin
    [Ecardz-Proto.kicad_pcb, Ecardz-Proto.step, NFC.kicad_sch, STM.kicad_sch, Same_Sky_CPG-05-N-B.step, s10051922_2410elf.stp]
2025-02-23 all tracks connected
    [Ecardz-Proto.kicad_pcb, Ecardz-Proto.step, NFC.kicad_sch]
2025-02-23 final silkscreens
    also made more space around antenna
    [Ecardz-Proto.kicad_pcb, Ecardz-Proto.step]
2025-02-24 final fit check complete.
    added updated step, wrl, gerbers and svg file used for silkscreen
    [Ecardz-Controller-B_Cu.gbr, Ecardz-Controller-B_Mask.gbr, Ecardz-Controller-B_Paste.gbr, Ecardz-Controller-B_Silkscreen.gbr, Ecardz-Controller-Edge_Cuts.gbr, Ecardz-Controller-F_Cu.gbr, Ecardz-Controller-F_Mask.gbr, Ecardz-Controller-F_Paste.gbr]
2025-02-24 final final mech spin
    [Ecardz-Proto-B_Cu.gbr, Ecardz-Proto-B_Mask.gbr, Ecardz-Proto-B_Paste.gbr, Ecardz-Proto-B_Silkscreen.gbr, Ecardz-Proto-Edge_Cuts.gbr, Ecardz-Proto-F_Cu.gbr, Ecardz-Proto-F_Mask.gbr, Ecardz-Proto-F_Paste.gbr]
